jeffersonjhunt/pinled/docs/REQUIREMENTS.md

# Firmware Requirements — `pinled` v2

Requirement IDs are stable; status is `MVP` (first working build), `v1`
(feature-complete for release), or `future`. "SHALL" = required, "SHOULD" =
desired, "MAY" = optional.

## 1. Sensing / scan

| ID | Req | Status |
|---|---|---|
| FR-SCAN-1 | The system SHALL scan lamp channels via daisy-chained 74x165 parallel-in / serial-out shift registers, two per module, reading channel state as one serial stream. | MVP |
| FR-SCAN-2 | The system SHALL support 16 channels per module (2× '165, the second feeding the first's `SER`). | MVP |
| FR-SCAN-3 | The system SHALL support 1..8 identical, unaddressed modules chained on a 5-conductor harness. `CLK` and `/PL` are bussed to every module; `DATA` is point-to-point, `QH` → `SER`, one push-pull driver per hop. See `CHAINING.md`. | MVP |
| FR-SCAN-4 | A scan frame SHALL raise `/PL` — capturing every channel in the chain on that one edge — then issue **16*N** clocks, sampling `DATA` in the middle of each bit cell. Stream bit *i* (MSB-first) SHALL be channel *i*; no samples are discarded. Any module count 1..8 SHALL be legal. | MVP |
| FR-SCAN-5 | Per-channel raw sample rate SHALL be configurable and default to 10 kHz. | MVP |
| FR-SCAN-6 | Channel active polarity SHALL be configurable, defaulting to **active-high** (FET + inverting Schmitt trigger = non-inverting front end). | MVP |
| FR-SCAN-7 | The clock burst SHOULD be generated by SPI + DMA (`SCLK`=`CLK`, `MISO`=`DATA`, mode 2, receive-only). `/PL` SHOULD be driven from `CS` with positive polarity, so the line is low between transactions (loading) and high during one (shifting) and the capture instant is hardware-timed. | MVP |
| FR-SCAN-8 | Sampling SHALL be paced to a fixed configured rate independent of channel count. The SPI transaction cadence provides this directly; no separate pacing timer is required. | MVP |
| FR-SCAN-9 | The driver SHALL measure actual frame time at boot, clamp the configured rate to what the hardware sustains at ≤ 60% core occupancy, and publish the resulting rate as the authoritative Fs for all downstream time-constant math. | MVP |
| FR-SCAN-10 | A frame SHALL be a **single** SPI transaction. The driver's fixed per-transaction overhead (~17 µs measured, `TIMING.md` §2.4) is paid once per frame, never once per module. | MVP |
| FR-SCAN-11 | A wrong `num_modules` SHALL degrade benignly in both directions: too high reads hard zeros from the chain terminator, too low leaves trailing modules unread. Neither SHALL shift or misalign the channels that are present. | MVP |

## 2. Filament (brightness reconstruction)

| ID | Req | Status |
|---|---|---|
| FR-FIL-1 | Each channel SHALL run a leaky integrator emulating an incandescent filament's thermal response. | MVP |
| FR-FIL-2 | Attack (rise) and decay (fall) time constants SHALL be independently configurable, default ~20–50 ms. | MVP |
| FR-FIL-3 | The integrator SHALL accept normalized duty (0..1) or per-sample boolean and output brightness 0..255. | MVP |
| FR-FIL-4 | A configurable output gamma/curve SHALL map integrator level → LED PWM to match perceived bulb response. | v1 |
| FR-FIL-5 | Math SHALL be fixed-point (no float in the hot loop) and run for ≥ 64 channels within frame budget. | MVP |

## 3. Auto-profiling

| ID | Req | Status |
|---|---|---|
| FR-PROF-1 | The system SHALL classify each channel as STEADY / MATRIX / AC_STEADY / AC_DIMMED / OFF from observed transitions. | v1 |
| FR-PROF-2 | Profiling SHALL run at boot and be re-armable at runtime. | v1 |
| FR-PROF-3 | Classifier output `{class, duty_norm, period_est, confidence}` SHALL seed each channel's integrator gain/attack/decay. | v1 |
| FR-PROF-4 | A machine profile MAY override or lock per-channel class/params. | v1 |
| FR-PROF-5 | The observation window SHALL be specified in milliseconds (default 500 ms–1 s) and the frame count derived from the measured Fs, so the window spans several AC and matrix periods at any channel count. | v1 |
| FR-PROF-6 | The classifier SHOULD be robust to correlated false edges from solenoid-induced ground bounce (e.g. discard frames in which an implausible fraction of channels transition together). | v1 |

## 4. LED output / mapping

| ID | Req | Status |
|---|---|---|
| FR-LED-1 | The system SHALL drive a WS2812B/SK6812 string from a single GPIO (RMT). | MVP |
| FR-LED-2 | A mapping table SHALL relate sensed channel → LED index(es) + base color. | MVP |
| FR-LED-3 | LED frame/refresh rate SHALL be configurable (default 60–120 Hz) and decoupled from scan rate. | MVP |
| FR-LED-4 | Per-lamp color/tint (e.g. warm-white for GI, colored inserts) SHALL be configurable. | v1 |
| FR-LED-5 | The renderer SHOULD gamma-correct and dither low levels to avoid visible stepping. | v1 |
| FR-LED-6 | The renderer SHALL build one frame and issue a single strip transmit per refresh, not one transmit per channel. | MVP |
| FR-LED-7 | A global brightness/current cap SHALL bound worst-case LED draw (~6 A at 128 LEDs full-on). | v1 |
| FR-LED-8 | `led_count` × per-LED transmit time SHALL be validated against `refresh_hz` at boot and the refresh rate clamped if it does not fit. | MVP |

## 5. Configuration / profiles

| ID | Req | Status |
|---|---|---|
| FR-CFG-1 | Machine profiles (per-lamp name, color, integrator params, profiler locks) SHALL persist across reboots. | v1 |
| FR-CFG-2 | Build-time defaults SHALL be settable via Kconfig (`idf.py menuconfig`). | MVP |
| FR-CFG-3 | Profiles SHALL be loadable/exportable as human-readable JSON — specifically proto3's canonical JSON mapping of the schema in FR-CFG-13, so the readable form is generated rather than separately maintained. | v1 |
| FR-CFG-4 | The system SHALL boot to sane defaults with no stored profile. | MVP |
| FR-CFG-5 | Configuration SHALL be split into two documents: a **machine profile**, keyed by the lamp's number in the machine's own lamp matrix and containing nothing install-specific, and an **install config** holding geometry, pins and wiring. Both SHALL be exportable and importable; only the machine profile SHALL be publishable to the shared registry. | v1 |
| FR-CFG-6 | The install config SHALL carry the channel → lamp-number → LED-index binding that joins the two documents. Importing a machine profile SHALL NOT modify geometry, pins or wiring. | v1 |
| FR-CFG-7 | Both documents SHALL be stored as protobuf files in a filesystem partition, not as NVS blobs (a 128-channel profile is ~16 KB as JSON; the NVS partition is 24 KB total). NVS SHALL retain only what it is good at — the small key-value settings needed at boot: Wi-Fi credentials and author handle. | v1 |
| FR-CFG-8 | Per-channel state SHALL include name, LED index, base color, profiler class lock, and attack/decay overrides — one record written by both the profiler and the UI, with the class lock deciding precedence. | v1 |
| FR-CFG-9 | A **version** SHALL be the install config and machine profile captured together with a label, timestamp and parent lineage, so a user can back up, keep alternative setups, compare them and revert. Versions SHALL be managed by the UI and stored in the user's private cloud area or as local files. | v1 |
| FR-CFG-10 | The device SHALL store exactly **one active configuration** and no version history — only one can be in effect, so on-device copies would be dead weight and a second thing to keep consistent. Switching versions is an ordinary config write; it need not be instantaneous, but the device SHALL report whether applying one required re-initialisation. | v1 |
| FR-CFG-11 | The UI SHALL retain the outgoing configuration when applying a new one, so fallback is a single action. No device-side rollback slot is required: no install-config value can lock the user out (pins, geometry and rates affect only scan and render, never the HTTP server), and Wi-Fi credentials are covered by FR-UI-7. | v1 |
| FR-CFG-12 | Wi-Fi credentials SHALL live in NVS only and SHALL NOT appear in any exported document, at any privacy level. Restoring a backup therefore requires re-provisioning. | v1 |
| FR-CFG-13 | A single `.proto` SHALL be the schema authority. Device ⇄ browser traffic and on-device storage SHALL be **protobuf** (nanopb); the firmware SHALL contain no JSON parser. The browser converts to and from JSON for files, sharing and diffing. Field numbering and unknown-field preservation are what make the FR-UI-4 version window work. | v1 |
| FR-CFG-14 | The document model (nested, named, optional) and the runtime model (flat POD array sized at init) SHALL be distinct types, with load projecting one onto the other — `NFR-4` forbids allocation in the per-frame path that reads the per-channel record. | v1 |
| FR-CFG-15 | Every stored document SHALL carry a CRC over its payload. Filesystem consistency is not write durability; they are different promises. | v1 |
| FR-CFG-16 | Applying a configuration SHALL be write-file-then-restart. In-place re-initialisation of the scan device, integrators and renderer is not required: this is a commissioning-time operation. | v1 |

## 5a. Configuration UI

Architecture, schema and rationale in `WEBUI.md`. The governing constraint is
that the cloud is a convenience and is never required: every function of the
product SHALL be reachable with no internet connection.

| ID | Req | Status |
|---|---|---|
| FR-UI-1 | The device SHALL serve an SPA shell over HTTP on the local network. The application bundle, images, help and registry content MAY be loaded from cloud storage over HTTPS. | v1 |
| FR-UI-2 | The device SHALL NOT make outbound requests to any web service. The browser is the only participant that communicates with both the device and the cloud. | v1 |
| FR-UI-3 | The device API SHALL be unauthenticated and SHALL send `Access-Control-Allow-Origin: *`, so that a standalone copy of the SPA run from `file://` (origin `null`) can reach it. | v1 |
| FR-UI-4 | `GET /api/v1/info` SHALL report an **API version** distinct from the firmware version, so a cloud-updated bundle can support field devices running older firmware. | v1 |
| FR-UI-5 | The device SHALL push live per-channel state and profiler classification over a WebSocket at ~30 Hz, carrying a **sticky "active since last push"** bit per channel (cleared on send) so activity between pushes is not lost. This reuses the FR-DIAG-1 mechanism. The frame is a protobuf envelope wrapping a packed `bytes` payload. | v1 |
| FR-UI-9 | The push task SHALL run at low priority off the scan core, and SHALL **drop pushes rather than stall `scan_task`** under load. The sticky bit makes a dropped push lossless. No message broker SHALL be introduced: a cloud broker violates FR-UI-2, and an on-device broker still needs the WebSocket underneath it. | v1 |
| FR-UI-6 | Unprovisioned, the device SHALL raise a SoftAP with a captive portal whose provisioning page is **self-contained on the device**, with no cloud dependency. After joining, it SHALL report both its mDNS name and its numeric IP. | v1 |
| FR-UI-7 | A button-held rescue path SHALL return a provisioned device to SoftAP mode. | v1 |
| FR-UI-8 | The SPA SHALL be downloadable as a standalone bundle that runs locally against the device API with no cloud access. | v1 |

## 5b. Firmware update

| ID | Req | Status |
|---|---|---|
| FR-OTA-1 | The device SHALL accept a firmware image by HTTP POST from the browser and apply it via the OTA API. It SHALL NOT fetch images itself. | v1 |
| FR-OTA-2 | An uploaded image SHALL be **staged into the inactive slot and not booted** until a **physical button press** confirms it, within ~30 s, with the pending state and its remaining time readable from the API. On expiry the staged image SHALL be discarded. Physical presence is the entire authorisation; open CORS otherwise leaves a bricking endpoint permanently exposed. *Confirming after the upload rather than arming before it is deliberate: writing an inactive slot is harmless, so the act worth gating is the boot-partition switch. The press then confirms a specific image the device has already verified, instead of opening a window in which anything on the LAN may be uploaded — and a truncated image can never reach the confirmation.* | v1 |
| FR-OTA-3 | Image integrity SHALL be checked against a published SHA-256 before upload, and ESP-IDF's app-descriptor validation SHALL remain enabled. Signed images / secure boot are `future`. | v1 |
| FR-OTA-4 | USB flashing SHALL remain a fully supported first-class update path, not a recovery hatch. | MVP |
| FR-OTA-5 | The partition table SHALL provide two OTA app slots plus a filesystem partition (`WEBUI.md` §7). | v1 |
| FR-OTA-6 | Rollback SHALL be enabled: a newly booted image SHALL mark itself valid only once it is serving the API, so a firmware that cannot reach that state is reverted by the bootloader without physical access. | v1 |
| FR-OTA-7 | While an image is staged, a short press SHALL confirm it **instead of** re-arming the profiler (FR-PROF-2), and the indicator SHALL show that the button's meaning has changed (FR-IND-3). The long-hold rescue (FR-UI-7) SHALL remain available in every mode without exception. | v1 |
| FR-REG-1 | Device identity SHALL derive from the factory eFuse MAC — no provisioning step and no stored secret. An optional author handle in NVS SHALL be stamped into exported profiles for attribution. Profile ownership itself is a cloud-side association and no device function SHALL depend on it. | v1 |
| FR-REG-2 | A registered account SHALL have a **private** area holding the user's version library, distinct from the public registry, and it is the only version store in the system (FR-CFG-10). The registry SHALL accept only machine profiles; install configs and versions are private. As with everything else, the browser mediates and the device is not involved (FR-UI-2). | v1 |

## 5c. Status indicator

One RGB pixel, and it exists for two jobs: telling somebody across a dark room
whether the machine is fine, and making the button's *current* meaning visible.
The second matters most — GPIO 0 changes meaning while an image is staged
(FR-OTA-7), and a modal control whose mode is invisible is a trap rather than a
feature.

| ID | Req | Status |
|---|---|---|
| FR-IND-1 | The board SHALL carry a status pixel on its own GPIO, distinct from the playfield string. It SHALL NOT consume a playfield LED: the string is the product, and a machine is commissioned by looking at it. | v1 |
| FR-IND-2 | State SHALL be encoded by **rhythm as well as colour**, such that every state is distinguishable by pattern alone. Red/green is not a distinction for roughly 8% of men, and this indicator is the sole feedback on a device with no screen. | v1 |
| FR-IND-3 | Solid SHALL mean a steady state and blinking SHALL mean the device wants something. A healthy machine is therefore still, and anything moving is a request. While an image is staged the indicator SHALL blink **faster as the confirmation window expires**, conveying the deadline without a display. | v1 |
| FR-IND-4 | Faults SHALL be signalled as *N* red blinks followed by a pause, *N* identifying the class per the table below, so a fault is diagnosable by eye and over a telephone without a serial cable. Counting SHALL start at **2**, because one blink and a pause reads as a heartbeat rather than a count. Where several faults are active the **lowest** number SHALL be shown; the API reports all of them. Red SHALL NOT imply the device is dark — it keeps running wherever it can, so red means *not doing what you asked*. | v1 |
| FR-IND-7 | Every press past the debounce threshold SHALL be acknowledged **immediately and identically**, before and independently of whatever it goes on to do, so that "did it register" is never a question. A press too short to count SHALL produce no acknowledgement, making the absence itself the answer. | v1 |
| FR-IND-8 | While the button is held past one second the indicator SHALL show progress toward the erase threshold, accelerating as it approaches, and SHALL return to the previous state if released early. The rescue countdown is otherwise visible only in a log nobody standing at a machine can read. | v1 |
| FR-IND-5 | Brightness SHALL be configurable in the install config, including **off**. The board may be visible in a backbox, and the indicator must never compete with the playfield. | v1 |
| FR-IND-6 | The indicator SHALL NOT be on the scan or render hot path: it is driven from a low-priority task and a dropped update is of no consequence. | v1 |

States, in the order they are reached:

| State | Colour | Rhythm |
|---|---|---|
| Booting | white | solid |
| Running, network up | green | solid, dim |
| Running, no network | green | slow breathe (~0.5 Hz) — works, not reachable |
| SoftAP / unprovisioned | blue | fast blink |
| Profiler pass running | white | one brief flash |
| **Image staged, press to confirm** | amber | blink, accelerating as the window expires |
| Writing / applying firmware | amber | solid — do not remove power |
| Fault | red | *N* blinks, pause, repeat |

Blue for SoftAP rather than green: it is a *mode awaiting action*, not a
degraded run, and it keeps the two states a person must tell apart off the
red/green axis entirely.

### Fault classes (FR-IND-4)

Grouped by **the subsystem someone can act on**, not by where the error was
raised, and ordered by expected frequency — a count is only useful if it is
easy to read, and the common ones get read most.

| Blinks | Class | Check |
|---|---|---|
| 2 | Sense bus | scan init failed, or no usable sample rate. The harness: `CLK INH` floating and a missing `QH`→`SER` are the top rev D faults |
| 3 | Configuration | a stored document was rejected — CRC, decode, or a value out of range. Running on defaults; re-apply from the UI |
| 4 | LED string | strip init failed or the geometry is impossible. Data line and LED count |
| 5 | Storage | the filesystem would not mount or would not write. Run the store self-test |
| 6 | Internal | out of memory, a task or the HTTP server would not start. A firmware bug, not a wiring fault |

Rate: 200 ms on, 200 ms off per blink, then a 1.2 s pause — so two blinks is a
2 s cycle, countable without being frantic.

### Press feedback (FR-IND-7, FR-IND-8)

| Moment | Indicator |
|---|---|
| press accepted (past debounce) | one **80 ms white blip**, whatever it will go on to do |
| press too short to count | **nothing** — the absence is the answer, and the log gives the duration |
| held ≥ 1 s | **red**, blinking faster each second toward the 5 s erase |
| released before 5 s | back to the previous state |
| after release | the action's own state — white flash for a profiler pass, solid amber for applying firmware |

Acknowledging the *press* rather than its *consequence* is the point. A profiler
pass cannot be the acknowledgement, because during a staged image the button
means something else and amber is already blinking — and because a press whose
only feedback is its outcome is indistinguishable from a press that never
registered. That exact ambiguity cost a bench session on 2026-08-14.

Red for the erase countdown overlaps the fault colour deliberately: it is a
destructive action one second away and red is what that deserves. It is
distinguishable because it happens only while the button is held, and because
it accelerates.

Fault classes for FR-IND-4 are assigned where the fault is raised; the mapping
belongs in `BRINGUP.md` beside the other things read off a board by eye.

## 6. Diagnostics

Bring-up aids. All default to off/normal so production behavior is unchanged;
see `BRINGUP.md` for how they are used together.

| ID | Req | Status |
|---|---|---|
| FR-DIAG-1 | The firmware SHALL be able to log the raw pre-filament channel bitmap plus a sticky per-channel "has been seen both high and low" flag (`PINLED_SCAN_DEBUG`), isolating the sense bus from the filament model and the LED string. | MVP |
| FR-DIAG-2 | The firmware SHALL be able to advance the scan at a human-visible rate (`PINLED_SCAN_STEP_MS`), logging each bit index, the channel it maps to, and the level read. The chain holds no analog state, so it can be clocked arbitrarily slowly. It SHALL re-assert `/PL` between steps rather than walking one frozen snapshot, so an input toggled part-way through the walk is still visible. | MVP |
| FR-DIAG-3 | The firmware SHALL be able to park the chain on a single channel indefinitely (`PINLED_SCAN_HOLD_CH`): snapshot, clock exactly *k* times, stop. `DATA` then holds channel *k* as a static DC level a meter can read. Holding `/PL` **low** instead is the useful special case — the registers stay transparent, so `DATA` tracks module 1 channel 0 *live*, following a button in real time. | MVP |
| FR-DIAG-4 | Modes that take ownership of the chain SHALL suppress `scan_task` rather than race it, and SHALL say so in the log. | MVP |

## 7. Non-functional

| ID | Req | Status |
|---|---|---|
| NFR-1 | Target ESP-IDF **5.5.x**, IDF_TARGET `esp32s3`. Reference board is the Adafruit QT Py ESP32-S3; the ESP32-S3-DevKitC-1 is a supported bring-up board (same GPIO numbers, see `HARDWARE.md`). Neither is the shipping form factor — the product places a bare S3 on the mainboard. | MVP |
| NFR-2 | Reusable logic (scan, filament, profiler) SHALL be ESP-IDF components with public headers under `include/`. | MVP |
| NFR-3 | Code style SHALL follow the existing repos: C++, `ooe::pinled` namespace, Doxygen headers, `esp_err_t` returns, `ESP_LOG*` with per-file `TAG`, `ESP_ERROR_CHECK`. | MVP |
| NFR-4 | No dynamic allocation in per-sample / per-frame hot paths. | v1 |
| NFR-5 | BOM target ≤ ~$25/strip; original ESP32-class MCU. | v1 |
| NFR-6 | License MIT; third-party attributions retained under `licenses/`. | MVP |
| NFR-7 | The CPU SHALL run at 240 MHz (`CONFIG_ESP_DEFAULT_CPU_FREQ_MHZ_240`). Every figure in `TIMING.md` §2 derives from it and the IDF default for `esp32s3` is 160 MHz, which inflates the frame budget by 1.5×. | MVP |
| NFR-8 | The shipping board SHALL carry **8 MB** flash (no PSRAM required). Two 3 MB OTA slots plus a filesystem partition do not fit in 4 MB with any margin (`WEBUI.md` §7). *(Settled 2026-08-08; the mainboard places a bare S3, so flash size is a BOM choice — cheap now, expensive after layout.)* | v1 |

## 8. Hardware contract

Properties of the board the firmware depends on. Changing one of these is a
firmware change, not just a hardware change — see `TIMING.md` for derivations.

| ID | Req | Status |
|---|---|---|
| HW-1 | The front end SHALL be non-inverting overall (level-shift MOSFET followed by an *inverting* Schmitt trigger, e.g. 74LVC14): lamp on → logic high. This sets the `active_low` default. | MVP |
| HW-2 | Every `DATA` net SHALL carry a ~10 kΩ pull-down **at its receiving end** — one per module on `J2.3`, plus one at the master on `MISO` — oriented so that an absent, unpopulated or unpowered upstream driver reads *lamp off*, which given HW-1 means pulled low. The MCU's internal pull on `MISO` SHALL be configured to match rather than left at the `gpio_reset_pin()` default (pull-up). HW-1, HW-2 and the internal pull are one decision. | MVP |
| HW-3 | Chain logic SHOULD be LVC family at 3.3 V, for edge rate and drive into the multi-drop `CLK` bus. `74LV165A` is an acceptable substitute; `74HC165` is acceptable at **≤ 4 MHz** and is the practical choice for a through-hole bench build. *(Relaxed from ≤ 2 MHz on 2026-08-07: 4 MHz ran clean on a 4-chip breadboard rig, 2 modules / 32 ch at 3.3 V, for millions of frames with zero read errors. The limit at longer chains is multi-drop `CLK` integrity across 800 mm, not the part — see HW-14 and `TIMING.md` §4.3 — so this ceiling is about the device, and chain length is governed separately.)* Since rev D there is no per-hop gate delay in the clock path, so family choice is no longer a chain-length correctness issue. | MVP |
| HW-4 | Modules SHALL chain on a **5-pin** JST-SH harness: `VCC` (5 V), `GND`, `DATA`, `CLK`, `/PL`, in ~100 mm hops, up to 8 modules / 800 mm. `CLK` and `/PL` are bussed; `DATA` is point-to-point and is the only signal that differs between `J1` and `J2`. | MVP |
| HW-5 | Each module SHALL carry local decoupling (100 nF per IC + ~10 µF bulk). `CLK` SHALL have 33–100 Ω series termination **at the master** (the bus source), and each module's `QH` SHALL have a 33 Ω series resistor before `J1` — source-terminating the point-to-point hop and current-limiting an output collision if a module is reversed. | MVP |
| HW-6 | pinled ground SHALL tie to the machine's lamp-return ground at a single point near the lamp matrix return. | MVP |
| HW-7 | The input SHALL survive rail sag from solenoid firing (series Schottky + bulk capacitance + kickback clamping) without an MCU brownout reset. | MVP |
| HW-8 | Distribution SHALL be 5 V on the harness with a local 3.3 V LDO on every module. LVC is not a 5 V part, so this is now required rather than preferred. Higher input rails require a single switching regulator at the controller, not per-module switchers adjacent to the sense bus. | MVP |
| HW-9 | The LED data line SHOULD be level-shifted to meet WS2812B V_IH (0.7 × VDD), or the strip run at a reduced VDD. | v1 |
| HW-10 | No analog time constant may appear anywhere in the chain. Every capture and every transfer SHALL be registered and edge- or level-defined. | MVP |
| HW-11 | The chain SHALL be **self-terminating**: a partially populated harness reads as lamps-off beyond the last fitted module, with no terminator plug, jumper or build variant (HW-2's per-module pull-down provides this). | MVP |
| HW-12 | Each module's serial output SHALL be taken from `QH`, never `/QH`. Inverting the serial output would make an absent module's pull-down read as every channel *on*, defeating HW-11. | MVP |
| HW-13 | `J1` (upstream, `DATA` = output) and `J2` (downstream, `DATA` = input) SHALL be keyed or gendered so a module cannot be fitted backwards, which would tie two push-pull outputs together. | MVP |
| HW-14 | The `CLK` bus SHALL be routed so it propagates *along* the harness, master to downstream, rather than star-wired. This keeps each module clocked before the one feeding it, so harness skew adds to the inter-device hold margin instead of eroding it (`CHAINING.md`). | MVP |
| HW-15 | The mainboard SHALL carry a **status pixel** (one WS2812-class RGB LED) on its own GPIO, with its own decoupling, sited so it is visible with the board installed. It SHALL NOT be the first pixel of the playfield string: the string is the product and is routed to the playfield, whereas this has to be readable at the board (FR-IND-1). On the QT Py bench board the onboard pixel serves, on GPIO 39 with power-enable on 38. | v1 |
| HW-16 | GPIO 0 (the BOOT button, or its equivalent on the mainboard) SHALL be the sole physical control, carrying three meanings distinguished by duration and context: short press re-profiles (FR-PROF-2), short press **while an image is staged** confirms it (FR-OTA-7), long hold erases the network (FR-UI-7). No second button is required, and the indicator is what makes the modal meaning legible (FR-IND-3). | v1 |

## 9. Out of scope (first cut)
- Any device-initiated call to a cloud service (FR-UI-2) — including
  device-pull OTA, telemetry, and cert issuance. The browser mediates.
- TLS on the device, and the per-device certificate infrastructure a
  cloud-hosted SPA would require (`WEBUI.md` §1).
- Device-side authentication or user accounts. Ownership and verification live
  in the sharing service (FR-REG-1).
- The cloud sharing service itself, and native mobile apps.
- Reverse-engineering per-title lamp tables (baseline behavior comes from
  sensing, not decoding ROM state).
- PCB/gerber design (tracked in the hardware repo, not firmware).

*Web config portal, Wi-Fi provisioning and OTA were out of scope through
2026-08-08 and are now specified in §5a/§5b.*
