jeffersonjhunt/pinled/docs/pinled_module_revC.kicad_sch

## KiCad design docs/pinled_module_revC.kicad_sch (2026-08-04)

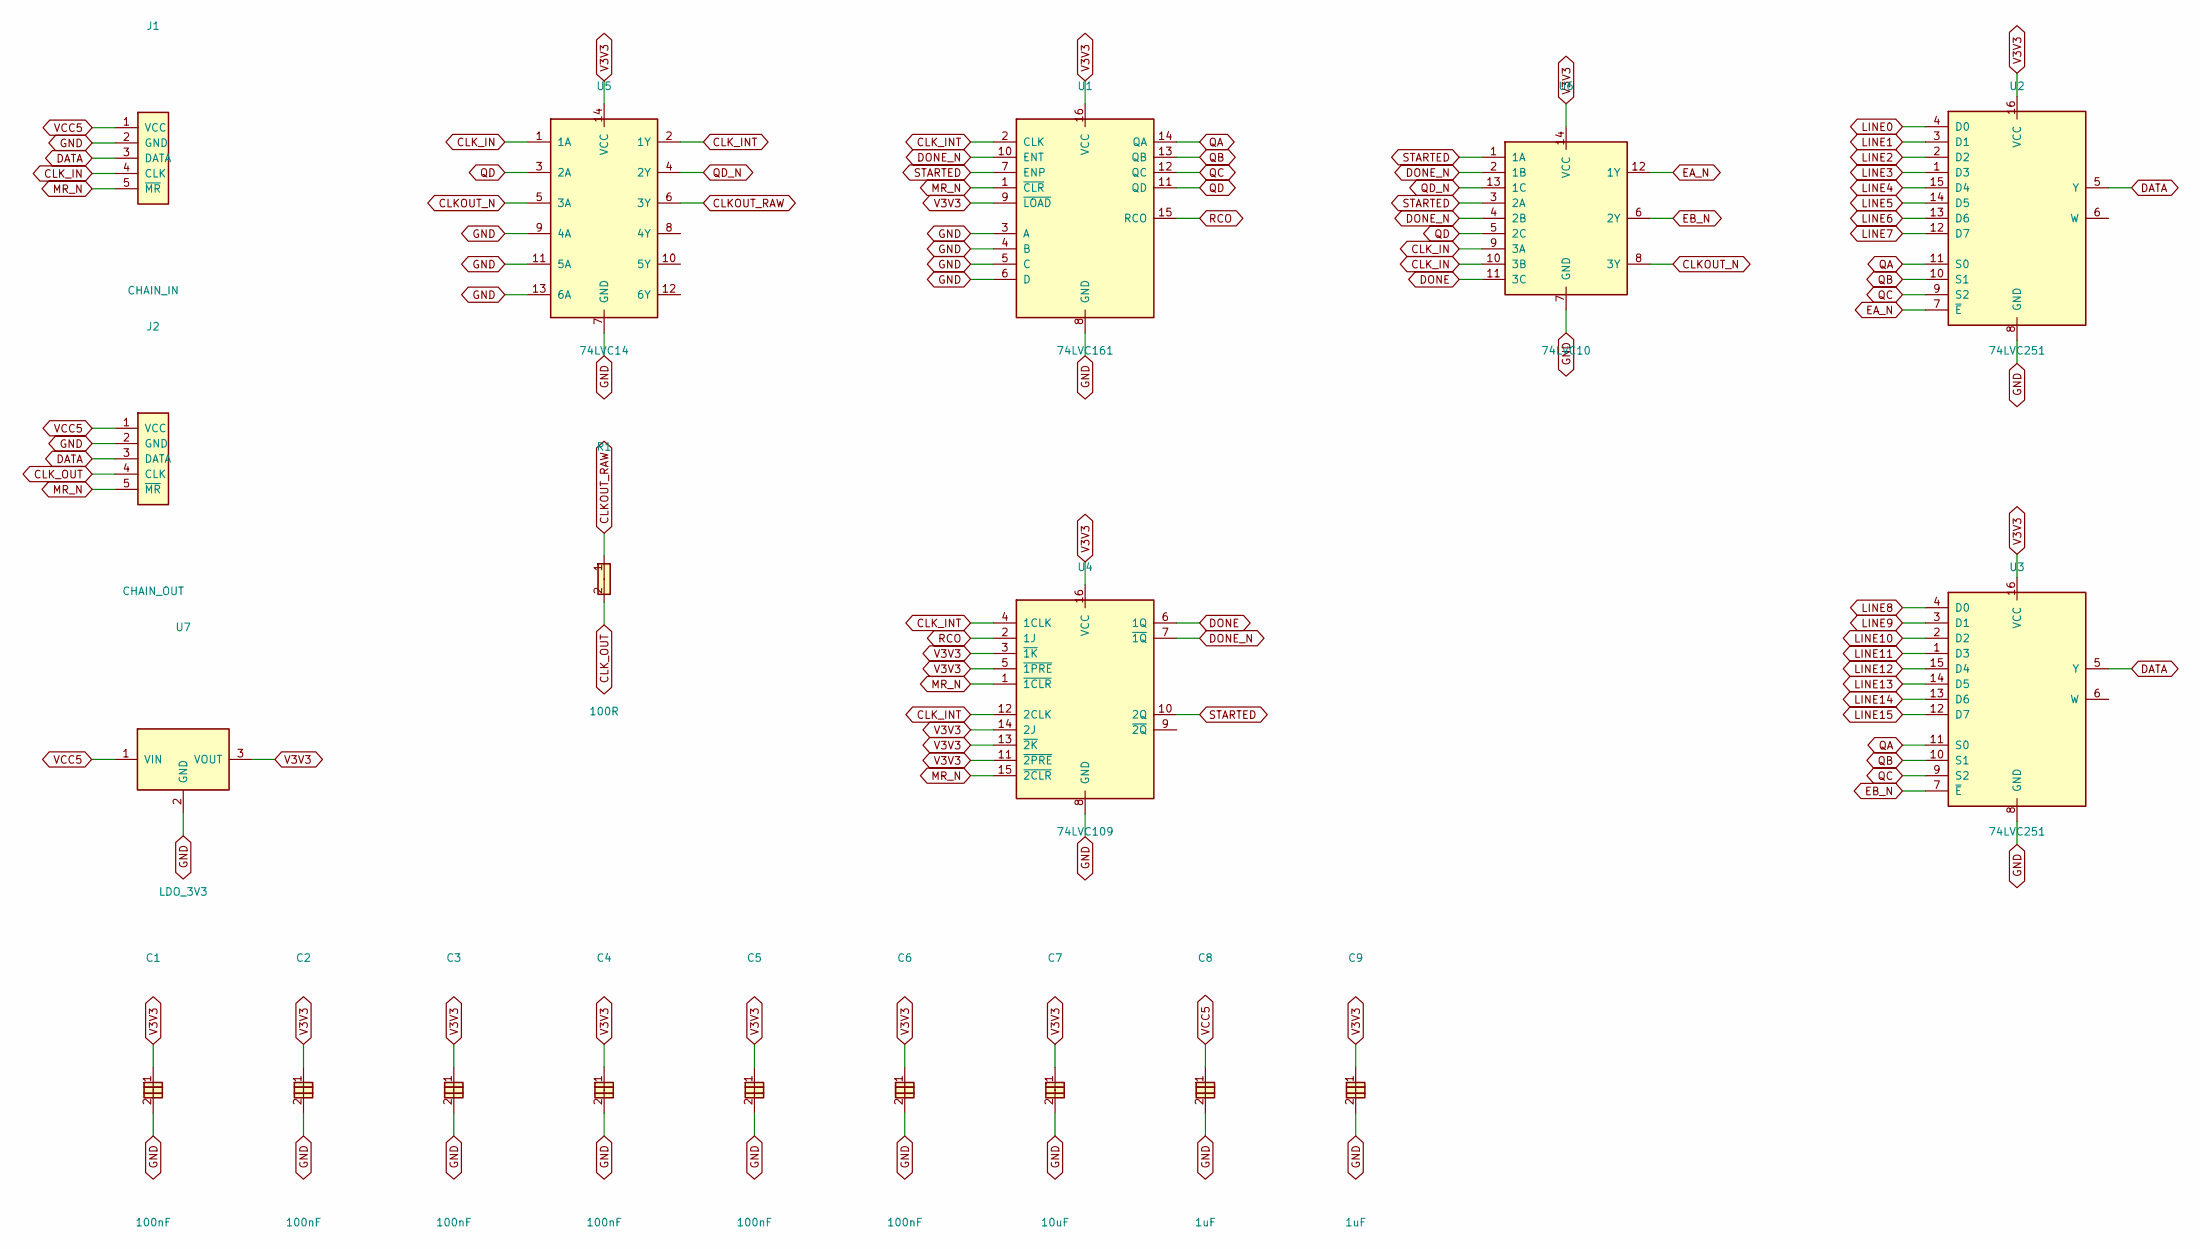
[picture p1: schematic pinled_module_revC.kicad_sch]

Parts:
C1, C2, C3, C4, C5, C6: 100nF
C7: 10uF
C8, C9: 1uF
J1: CHAIN_IN
J2: CHAIN_OUT
R1: 100R
U1: 74LVC161
U2, U3: 74LVC251
U4: 74LVC109
U5: 74LVC14
U6: 74LVC10
U7: LDO_3V3

Connections:
CLKOUT_N: U5.5 (3A), U6.8 (3Y)
CLKOUT_RAW: R1.1, U5.6 (3Y)
CLK_IN: J1.4 (CLK), U5.1 (1A), U6.9 (3A), U6.10 (3B)
CLK_INT: U1.2 (CLK), U4.4 (1CLK), U4.12 (2CLK), U5.2 (1Y)
CLK_OUT: J2.4 (CLK), R1.2
DATA: J1.3 (DATA), J2.3 (DATA), U2.5 (Y), U3.5 (Y)
DONE: U4.6 (1Q), U6.11 (3C)
DONE_N: U1.10 (ENT), U4.7 (~1Q), U6.2 (1B), U6.4 (2B)
EA_N: U2.7 (~E), U6.12 (1Y)
EB_N: U3.7 (~E), U6.6 (2Y)
GND: C1.2, C2.2, C3.2, C4.2, C5.2, C6.2, C7.2, C8.2, C9.2, J1.2 (GND), J2.2 (GND), U1.3 (A), U1.4 (B), U1.5 (C), U1.6 (D), U1.8 (GND), U2.8 (GND), U3.8 (GND), U4.8 (GND), U5.7 (GND), U5.9 (4A), U5.11 (5A), U5.13 (6A), U6.7 (GND), U7.2 (GND)
LINE0: U2.4 (D0)
LINE1: U2.3 (D1)
LINE2: U2.2 (D2)
LINE3: U2.1 (D3)
LINE4: U2.15 (D4)
LINE5: U2.14 (D5)
LINE6: U2.13 (D6)
LINE7: U2.12 (D7)
LINE8: U3.4 (D0)
LINE9: U3.3 (D1)
LINE10: U3.2 (D2)
LINE11: U3.1 (D3)
LINE12: U3.15 (D4)
LINE13: U3.14 (D5)
LINE14: U3.13 (D6)
LINE15: U3.12 (D7)
MR_N: J1.5 (~MR), J2.5 (~MR), U1.1 (~CLR), U4.1 (~1CLR), U4.15 (~2CLR)
QA: U1.14 (QA), U2.11 (S0), U3.11 (S0)
QB: U1.13 (QB), U2.10 (S1), U3.10 (S1)
QC: U1.12 (QC), U2.9 (S2), U3.9 (S2)
QD: U1.11 (QD), U5.3 (2A), U6.5 (2C)
QD_N: U5.4 (2Y), U6.13 (1C)
RCO: U1.15 (RCO), U4.2 (1J)
STARTED: U1.7 (ENP), U4.10 (2Q), U6.1 (1A), U6.3 (2A)
V3V3: C1.1, C2.1, C3.1, C4.1, C5.1, C6.1, C7.1, C9.1, U1.9 (~LOAD), U1.16 (VCC), U2.16 (VCC), U3.16 (VCC), U4.3 (~1K), U4.5 (~1PRE), U4.11 (~2PRE), U4.13 (~2K), U4.14 (2J), U4.16 (VCC), U5.14 (VCC), U6.14 (VCC), U7.3 (VOUT)
VCC5: C8.1, J1.1 (VCC), J2.1 (VCC), U7.1 (VIN)
