jeffersonjhunt/pinled/(commit log)

2026-07-17 migrate to version 0.2.0
    [partitions.csv]
2026-07-17 fix stack overflow in auto-profiling: move channel arrays to heap
    [main.cpp]
2026-07-28 plan chained-module architecture: timing budgets, S3 retarget, polarity flip
    Design pass for the chained-module scan bus (8-128 channels) on the
    QT Py ESP32-S3. Docs only, plus three default-value flips.
    New docs/TIMING.md covers:
    - sense-side frame budget across 1-8 modules (3.2 us at 16 ch,
    23.5 us at 128), and why the scan rate must be paced at a fixed
    10 kHz rather than free-run: frame time is linear in channel
    count, so a Kconfig sample-rate constant makes the filament time
    constants wrong by 3-25x depending on configuration
    - dedic_gpio (~8 ns/op, S3 only) as the baseline, not a future
    optimization; the bundle must be created on the scan task's core
    - LED bud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
    [lamp_scan.h, machine_config.h]
2026-07-28 M0.5: retarget to esp32s3 (QT Py ESP32-S3, 8MB no PSRAM)
    Build target, flash size, console routing, and the four GPIO defaults.
    No functional changes to the scan/filament/render path - that is M1a.
    - CONFIG_IDF_TARGET esp32 -> esp32s3, 8 MB flash (FN8C0 variant)
    - CONFIG_ESP_CONSOLE_USB_SERIAL_JTAG: the QT Py ESP32-S3 has no
    USB-UART bridge, USB-C goes straight to the S3's native USB.
    Without this the console sits on UART0 and monitor shows nothing.
    - both CMake presets retargeted
    - pins remapped to 18/17/9/8 (A0-A3). The POC defaults were not just
    wrong but unusable: GPIO 26 and 27 are SPI flash pins on the S3,
    and 15 and 25 are not broken out on this board.
    - PIN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
    [machine_config.cpp]
2026-08-02 set CPU frequency to 240 MHz
    The esp32s3 IDF default is 160 MHz. Every scan-budget number in
    docs/TIMING.md section 2 is derived from a 240 MHz LX7, so the default
    inflated the frame budget by 1.5x (~8 ns -> ~12.5 ns per dedic_gpio op,
    23.5 us -> ~35 us for a 128-channel frame).
    Caught on first hardware bring-up of the ESP32-S3 DevKit; "cpu freq:
    160000000 Hz" in the boot log. Verified 240 MHz after reflash.
2026-08-02 add scan bring-up diagnostic; fix DATA_IN internal pull
    Two problems found during first hardware bring-up with test inputs.
    lamp_scan: gpio_reset_pin() enables the internal pull-UP and
    gpio_set_direction() does not clear it, so DATA_IN sat with a ~45k
    pull-up. That fights the module's 1k bias resistor and, with the
    non-inverting front end, makes an undriven bus read "lamp on" -- the
    opposite of HW-2. Now configured explicitly, with the internal bias
    following active_low so polarity and bias stay one decision.
    main: nothing observable existed short of the LED string, so a dead
    scan chain and a dead LED path looked identical. PINLED_SCAN_DEBUG
    (default y) logs the raw pre-filament bitmap at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
    [lamp_scan.cpp, main.cpp, main.h]
2026-08-02 add slow-step scan mode for counter bring-up
    At normal speed the scan runs ~50k frames/s, so the '161 Q outputs
    toggle near 800 kHz and indicator LEDs on them read as steadily lit.
    That makes "is the counter counting?" unanswerable by eye, which is
    exactly the question during first bring-up.
    PINLED_SCAN_STEP_MS (default 0 = off) advances the scan one channel
    every N ms instead, logging the count, the Q pattern to expect, and the
    DATA_IN level at each step. While non-zero, scan_task is not started so
    the walk owns the counter position.
    lamp_scan gains step_counter() / sample_now() to expose single-step
    control without disturbing read_frame().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
2026-08-02 add hold-channel bring-up mode
    The slow-step walk proves whether the counter counts, but it sweeps past
    any given channel for only a few hundred ms per cycle, which is useless
    for tracing a dead signal path with a meter.
    PINLED_SCAN_HOLD_CH (default -1 = off) pulses /MR, clocks to one channel
    and stops. Every node from the '161 Q outputs through the mux address
    lines, the selected data input, Y, and the MCU pin becomes a static DC
    level, so the break can be localized by measuring along the chain.
    Takes precedence over PINLED_SCAN_STEP_MS; both suppress scan_task.
2026-08-03 docs: record M0.5/M1b results, DevKit, 240 MHz, diagnostics
    Docs had not caught up with this session's hardware bring-up.
    - BRINGUP.md (new): the three diagnostics as a ladder, fault signature
    tables, '151 bench substitution caveats, and the tooling traps that
    present as hardware faults -- port-open resets the board via RTS, ROM
    download mode is indistinguishable from a hang, new Kconfig symbols
    need a reconfigure.
    - REQUIREMENTS: NFR-7 pins the CPU at 240 MHz (TIMING section 2 derives
    from it; the IDF esp32s3 default is 160). New section 6 FR-DIAG-1..4
    for the diagnostics. HW-2 now covers the MCU internal pull. NFR-1
    admits the DevKitC-1 and notes neither dev board is the shi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
2026-08-03 docs: adopt the 4-wire clock-forwarding chain design
    Replaces the strapped-module-ID scheme (which was my inference and was
    never built) with the clock-as-token design from schematic rev A, plus
    the decisions taken on review.
    Design decisions carried in:
    - 4-pin JST-SH: VCC, GND, DATA, CLK. No /MR conductor -- the frame
    reset is a clock-idle timeout. Frees GPIO 17.
    - Master clocks the frame as one receive-only SPI + DMA transaction,
    mode 1. This is correctness, not optimization: the chain holds bus
    arbitration on an RC and a mid-frame stall silently resets it.
    Deletes the dedic_gpio bundle and the gptimer pacing.
    - 1 kOhm DATA bias retained, at the master only (rev A proposed 100k).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
    [pinled_module.kicad_sch]
2026-08-03 lamp_scan: clock the chain from SPI + DMA
    Replaces the bit-bang scan loop with one receive-only SPI transaction
    per frame (M1a). SCLK = CLK, MISO = DATA, no CS, no MOSI. Collapses
    data_pins[] to a single data_pin, and makes mr_pin optional: production
    modules have no reset conductor and clear on the clock-idle timeout, so
    CONFIG_PINLED_MR_GPIO now defaults to -1 (not fitted).
    The diagnostics need per-edge control of CLK, which SPI cannot give, so
    compiling in PINLED_SCAN_STEP_MS or PINLED_SCAN_HOLD_CH selects the
    bit-bang backend instead. Both are bench-rig only regardless.
    SPI mode corrected to 0, and the docs with it. The earlier docs claimed
    mode 1 on the reasoning that it "samples just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
    [lamp_scan.cpp, lamp_scan.h, machine_config.cpp, machine_config.h, main.cpp]
2026-08-03 docs: record SPI + mode-0 validation on the bench rig
    Adding a 74HC14 in the CLK path makes the bench rig advance its counter
    on the falling edge, as a real module does. With that, mode 0 reads
    inputs D4-D7 at channels 4-7 with no shift, confirming the sample lands
    mid-window and line 0 is captured.
    That validates the production sampling phase without rev B hardware --
    the one part of the SPI design that previously could not be checked. The
    inverter mod is now recommended in BRINGUP section 5.
2026-08-03 add chain clock sweep diagnostic; record measured ceiling
    PINLED_SPI_SWEEP steps the chain clock 1..40 MHz and reports, per rate,
    how many of 256 reads agreed and the union of every bit seen. Needs one
    held input and no reflash per step; lamp_scan gains set_clock() to
    re-open the SPI device at a new rate.
    Measured on the '161 + '151 rig (HC parts, breadboard, extra 74HC14 in
    the clock path):
    1-16 MHz 256/256 stable, correct channel
    20-26.7 MHz 256/256 stable, OFF BY ONE CHANNEL
    40 MHz unstable
    The break between 62.5 ns and 50 ns puts the endpoint round-trip delay
    at ~55-60 ns, consistent with `delay < T_clk` -- the same inequality
    TIMING section 4.3 applies to chain skew,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
    [lamp_scan.cpp, lamp_scan.h, main.cpp, main.h]
2026-08-04 rev C: 5-wire chain with /MR, drop the RC activity detector
    Adds a fifth conductor and spends the '109's unused second half on a
    STARTED latch, replacing the RC that rev B used for bus arbitration.
    /MR alone could not have done it: after a reset every module has
    DONE=0, so gating /OE on /DONE would put every module on the bus at
    once. A module still needs local evidence that its turn began -- it just
    does not need a capacitor for it.
    What that removed:
    - tau and the >=5tau idle gap. 128 ch now 68 us/frame, ceiling
    ~14.5 kHz against rev B's 10.9 kHz.
    - The ~6 us mid-frame stall cliff. SPI+DMA is now a throughput choice,
    not a correctness requirement.
    - D1/R1/C1, and with them a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
    [pinled_module.kicad_sch, pinled_module_revC.kicad_sch]
2026-08-04 docs: record CS-driven /MR validation and the stale-log trap
    /MR from SPI CS with SPI_DEVICE_POSITIVE_CS verified on the bench rig:
    channels 4-7 read correctly including simultaneous presses, so the
    frame reset is hardware-timed with no software involvement. That was
    the rev C mechanism most likely to need adjusting; it did not.
    Also records a tooling trap I walked into. The serial logger had a fixed
    2 hour lifetime and expired under a second before a round of button
    presses. Its tail showed all-zeros with no toggles -- indistinguishable
    from a dead scan -- and I read it as a regression in a design that was
    working, while the user was watching the LEDs light correctly. The
    logger now runs u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
2026-08-04 lamp_map: one strip transmit per frame (FR-LED-6)
    render() called neopixel_SetPixel(ctx, &px, 1) once per channel. The
    driver silently discards calls spaced closer than one strip time -- its
    own header says "some data will simply not be displayed" -- and those
    calls were issued microseconds apart, so most were thrown away and LEDs
    kept showing stale values. This was a correctness bug, not just a
    wasteful one, which is why FR-LED-6 is a SHALL.
    Now the whole strip is built into a frame buffer allocated once at init
    (never in the render path, NFR-4) and transmitted once. LEDs with no
    channel mapped are driven dark, so the output is a pure function of
    levels[] rather than of what was displayed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
    [lamp_map.cpp, lamp_map.h]
2026-08-04 wire in 10 kHz pacing and the boot feasibility check
    FR-SCAN-5/8: a gptimer at Fs notifies scan_task, one frame per tick.
    Uniform dt is what the filament integrator assumes, so this is a fixed
    tick rather than burst-and-sleep. ulTaskNotifyTake returns the pending
    count, so a value above 1 means alarms fired while we were still busy;
    those are counted and warned about, rate-limited. The old free-running
    loop with its periodic vTaskDelay to feed the WDT is gone -- the task
    now blocks on the notification, which yields naturally.
    FR-SCAN-9: measure_and_clamp_fs() free-runs 256 frames at boot, times
    them, and clamps the configured rate to 60% of the free-run ceiling. The
    clamped value -- not the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
    [lamp_scan.cpp, main.cpp, main.h]
2026-08-04 rev D: replace the counter+mux chain with 74x165 shift registers
    Rev C spent six logic ICs per module building a distributed state
    machine whose only job was taking turns on a shared DATA bus. A shift
    register chain is taking turns, so the state machine disappears: two
    '165s per module, QH -> SER between them, CLK and /PL bussed.
    What changes:
    - 16 clocks per module instead of 17. No arm clock, nothing discarded;
    a '165 presents channel 0 at QH while /PL is still low.
    - All 16*N channels captured on one edge (the /PL rise) instead of
    swept across the frame. Channel 0 and channel 127 were 35 us apart.
    - SPI mode 0 -> mode 2. The '165 shifts on the rising edge, so the
    master samples on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
2026-08-07 rev D: convert lamp_scan from the 17*N counter framing to 16*N shifts
    The docs went to rev D in 2c903eb while the code still implemented rev C.
    This closes that gap.
    Framing: a frame is now exactly 16 clocks per module. There is no arm clock
    and nothing is discarded, so stream bit i is channel i and the unpack loop
    loses its stride arithmetic. Both legal channel counts are whole bytes, so a
    frame also carries no surplus clocks.
    /PL replaces /MR throughout (mr_pin -> pl_pin, PINLED_MR_* -> PINLED_PL_*,
    PINLED_ARM_CLOCK deleted). The CS mechanism is unchanged -- positive-polarity
    CS, low between transactions, high during -- but the GPIO fallback path
    inverts: /MR idled high, /PL idles low so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
    [lamp_scan.cpp, lamp_scan.h, machine_config.cpp, machine_config.h, main.cpp, main.h]
2026-08-07 sdkconfig: target the FH4R2 QT Py (4 MB flash), not the FN8C0
    The bench board that arrived is the 4 MB flash / 2 MB PSRAM variant; the
    defaults were written for the 8 MB no-PSRAM part. Both variants share a
    silkscreen and a USB VID/PID, so the comment now records how to tell them
    apart and why 4 MB is correct for either: partitions.csv needs ~1.06 MB, and
    declaring 8 MB on an FH4R2 configures flash that is not present.
2026-08-08 docs: SPI mode 2 is measured, not reasoned
    The single unmeasured claim the rev D framing rested on was settled on the
    bench 2026-08-06: a 4x 74HC165 rig (2 modules, 32 ch) at 4 MHz read U1.D as
    channel 4 and U2.D as channel 12, exactly. The exact landing is the proof --
    mode 3 samples on the shift edge and would slide the whole frame by one, so
    alignment from bit zero fixes CPHA as well as CPOL. Re-confirmed 2026-08-07 on
    a QT Py ESP32-S3 (FH4R2).
    The same run settled bit order (H first, no byte reversal), the QH->SER handoff
    within and across a module boundary, /PL from CS, and frame timing (26.8 us for
    32 ch -> 37274 Hz free-run, 27% duty at 10 kHz).
    Also downgrades the '165 pinout cavea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
    [lamp_scan.cpp, lamp_scan.h]
2026-08-08 docs: HW-11 self-termination confirmed on the bench
    Chips 3-4 pulled live from the 4x '165 rig 2026-08-07. Channels 16-31 held a
    hard zero across ~4.9 M frames with not one toggle flag set.
    The positive control is what makes it conclusive rather than merely quiet: with
    the module out, U1.D still read channel 4 and U2.D channel 12, so the frame was
    still 32 bits and the trailing 16 were genuinely being clocked from a
    pulled-down SER rather than from a dead chain. Groups 3-4 also stayed clean
    DURING those presses, so the 10k terminator holds against crosstalk on the
    shared CLK//PL bus, not just against quiescence.
    Every rev D correctness claim is now measured. What remains is diagnostic
    poli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
2026-08-08 docs: describe the bench rig as actually wired
    The rig has four buttons, not 32: the D input (pin 14) on each of the four
    chips, channels 4/12/20/28. Every other input is wired straight to ground
    rather than through a pull-down. BRINGUP said "each input gets a switch to 3V3
    and a 10k pull-down", which described an intended rig, not the built one.
    This matters for the pinout caveat. Pins 3, 4, 5, 6 and 13 are not merely
    untested, they are untestable as wired -- hard-grounded inputs read 0
    permanently and produce no evidence either way. Confirming them needs a button
    moved or a ground lifted, so the caveat now says so instead of implying a press
    would settle it.
    Also records that all four bu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
2026-08-08 docs: '165 pin 6 (H, channel 0) confirmed by button press
    A button moved onto U1 pin 6 gave raw [10000000 ...] and tog [T------- ...] --
    exactly one channel, no neighbours. Channel 0 is the only channel whose capture
    timing differs, being the bit /PL presents before any clock arrives, so reading
    it correctly is direct evidence that CPHA=0 catches the pre-clock bit. Every
    other channel can only establish that by inference from frame alignment.
    Remaining unconfirmed pins are 3, 4, 5 and 13 (E, F, G, C), and the rig cannot
    exercise them as wired -- they are hard-grounded, so they read 0 permanently.
    Also records two bench traps that produced a false result first time round:
    - A first attempt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
2026-08-08 docs: last stale mode-2 claim, and record 4 MHz on 74HC165
    CHAINING.md still carried "Reasoned, not yet measured" for mode 2 -- missed
    because the earlier sweep was case-sensitive and the heading capitalised it.
    Replaced with the measurement, including the channel-0-via-H result that
    settles CPHA directly rather than by inference.
    Separately, five places capped 74HC165 at 2 MHz, but the bench rig has run the
    whole validation at 4 MHz on a breadboard for millions of frames with zero read
    errors. The descriptive docs now record that. The guidance is not simply
    relaxed: what fails first at eight modules is multi-drop CLK integrity across
    800 mm, a harness-length problem rather than a part-spee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
2026-08-08 HW-3: relax 74HC165 ceiling from 2 MHz to 4 MHz
    Measured basis: a 4-chip breadboard rig (2 modules, 32 ch) at 3.3 V ran the
    whole rev D validation at 4 MHz for millions of frames with zero read errors --
    mode 2, bit order, chain handoff, HW-11 self-termination, hot-plug recovery and
    channel 0 via input H were all established at that rate.
    The old figure had also been contradicting the shipped firmware: PINLED_SPI_HZ
    has defaulted to 4000000 all along, with Kconfig help explaining why 2 MHz is
    too slow (a 128-channel frame is 81 us at 2 MHz, which the boot check clamps
    below the 10 kHz target; at 4 MHz it is 49 us and fits). The requirement and the
    default now agree.
    Scope: this ceiling is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
2026-08-08 docs: drop the MCP23S17 study, fold its verdict into DOSSIER
    The file was deleted during the rev D work but the deletion was never
    committed, while TIMING.md and DOSSIER.md both still cited it by filename.
    Committing the deletion alone would have left two dangling references.
    Its rejection rationale now lives inline in DOSSIER.md section 3, expanded from
    the one-paragraph summary that was there to the full four reasons. Two of them
    were recorded nowhere else:
    - Sample skew: read serially, ch 0 and ch 127 land ~160 us apart, against rev
    C's 35 us spread and rev D's single capture edge.
    - The revival condition: queueing all eight reads with spi_device_queue_trans()
    so the driver's ISR ch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
2026-08-08 M1b complete: /PL held low tracks channel 0 live (FR-DIAG-3)
    A PINLED_SCAN_HOLD_CH=0 build on the 4x '165 rig logged DATA=0 at idle, DATA=1
    for the ~24 s the channel-0 button was held, and DATA=0 on release. One clean
    transition each way, no chatter, and no clocking involved -- the registers stay
    transparent and follow the input, which is what FR-DIAG-3 claims and what rev C
    had no equivalent of.
    The rig was already wired for it: the button had been moved to U1 pin 6 for the
    channel-0 pinout check, and pin 6 IS channel 0.
    That was M1b's last open item. All four diagnostics (FR-DIAG-1..4) are now
    exercised on real hardware, so the outstanding list no longer contains anything
    the bench rig c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
2026-08-08 docs: flag SCR holding current as a front-end constraint, not a power estimate
    Jefferson's bench chain is now complete -- Alltek Ultimate MPU + Ultimate Test
    Card + two Bally lamp driver boards (AS-2518-52 Aux Rev 3, and NVRAM's
    replacement LDB Rev 16) -- so real lamp drive can be tapped at a real socket.
    Looking at those boards surfaced a design question these docs have never
    answered: does the original incandescent stay in the socket? On a
    transistor-driven machine that is a power question. On SCR-latched Bally/Stern
    it is a functional one. An SCR conducts only while its load draws holding
    current, which a ~250 mA incandescent supplied for free. Replace it with a
    high-impedance sense tap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
2026-08-08 docs: front end carries jumper-selectable phantom loads and half-wave rectify
    Documents what was already the design intent but had never been written down.
    The original incandescent is removed -- that is the entire point of the product
    -- which makes the module front end responsible for two electrical jobs the
    bulb was doing for free:
    1. SCR holding current. Bally/Stern-era drivers latch with SCRs that conduct
    only while their load draws holding current. A ~250 mA bulb supplied it; a
    sense tap does not. Known field fix is ~470 ohm across the socket, ~13 mA at
    6.3 VAC.
    2. Supply regulation. The lamp rails are unregulated and specified under load.
    Strip most of the load out and th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
2026-08-08 docs: specify the configuration UI, profile sharing and OTA
    Web config portal, Wi-Fi provisioning and OTA were listed as out of
    scope. They are now specified, with the governing constraint that the
    cloud is a convenience and never a requirement — every function of the
    product is reachable with no internet connection.
    New docs/WEBUI.md covers the architecture and the reasoning behind it:
    - The SPA *shell* is served from the device; the bundle, images, help and
    registry content load from S3. The device makes no outbound calls at
    all. This split is forced by mixed-content rules — an HTTPS page cannot
    fetch HTTP, so a cloud-hosted SPA would require per-device TLS certs
    and ACME on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
2026-08-08 docs: install config is private, not device-bound; add snapshots
    "Never leaves the device" was the wrong granularity for the install
    config. It is ordinary user data — exportable, importable, and backed up
    to the user's private cloud area so a build survives a dead board. What
    it must never do is enter the *shared* registry, since it describes one
    physical build. The restriction that genuinely holds relocates to a
    single field: Wi-Fi credentials stay in NVS and appear in no export at
    any privacy level, so a restore implies re-provisioning.
    Adds snapshots (WEBUI.md 3a) for backup and A/B testing: a named,
    timestamped capture of the install config and machine profile *together*,
    with parent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
2026-08-08 docs: versions live off the device, not in a snapshot store on it
    Two corrections. Only one configuration can be in effect at a time, so a
    version library in the device partition is dead weight and a second thing
    to keep consistent — the device now stores exactly one active install
    config and machine profile, with no history. Versions are managed by the
    SPA and live where the user's other data already does: their private
    cloud area, or plain JSON files on local disk for the offline path.
    And A/B did not call for instant switching, only easy flipping with easy
    fallback. The hot/cold field table and the live-apply requirement are
    dropped. Flipping is an ordinary config write; the device onl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
2026-08-08 docs: add a working UI mockup as a design reference
    docs/ui-mockup.html is a self-contained page — no build step, no network,
    no dependencies — simulating the configuration UI specified in WEBUI.md.
    Its job is to make those decisions arguable before any of them is built:
    the learn-wiring flow, the machine-profile/install-config split, per-lamp
    presentation, versions, and OTA arming.
    The channel grid runs the same leaky integrator the firmware does, with
    the per-lamp attack/decay applied, so changing a fade shows the
    reconstruction behaving rather than a mock of it. Drive class is drawn as
    a waveform rather than a coloured chip: a class *is* a waveform, it reads
    faster than a legend, and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
2026-08-09 docs: protobuf on the wire, JSON where people read it; plan M3 in order
    Settles the M3 implementation decisions.
    A single .proto is the schema authority. Device traffic and on-device
    storage are protobuf via nanopb, so the firmware carries no JSON parser
    at all — no DOM parse of a 16 KB document on a 512 KB SRAM part. The
    browser converts to and from JSON for files, sharing and diffing, using
    proto3's canonical JSON mapping, so the readable form is generated from
    the same schema rather than separately maintained and free to drift.
    This also makes the FR-UI-4 version window rigorous rather than hopeful:
    field numbers and unknown-field preservation are exactly the mechanism a
    cloud-updated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
2026-08-09 docs: M3 runs on the bench QT Py, on a branch
    Drops the recommendation to move M3 to the DevKitC-1. The rig is wired
    and working; it is not being rebuilt to suit a milestone.
    The concern that prompted it — keeping a known-good diagnostic build
    available while the config work proceeds — is handled by a branch. The
    step-0 partition table is deliberately compatible with the current build:
    2 MB factory holds the existing app with room, so the table is flashed
    once and switching between builds afterwards is an ordinary app flash,
    with no table thrash or re-erase.
2026-08-10 M3 step 1: the schema, and a host test rig that runs
    proto/pinled.proto is the schema authority (FR-CFG-13) — machine profile,
    install config, version, device API and the live frame. It carries the
    compatibility rules in the header comment, because they are what makes
    FR-UI-4's version window real rather than aspirational: never reuse a
    field number, never change a type, burn removed numbers as reserved, and
    a zero value must always mean "as before". No floats anywhere; the
    firmware is fixed-point and a float on the wire invites the two
    implementations to drift.
    pinled.options bounds every string and repeated field so nanopb can
    generate static structs with no malloc, and records the arit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
    [harness.h, pbtool.py, test_crc32.cpp, test_doc_frame.cpp]
2026-08-10 M3 step 1 complete: schema round-trips against a second implementation
    Finishes step 1. protoc 3.21.12 is now installed on intel-nuc.tworivers,
    with a venv at ~/.venvs/pinled-tools (protobuf, nanopb) and the nanopb C
    runtime cloned to ~/.local/src/nanopb pinned at 0.4.9 — the pip package
    ships the generator only.
    38 cases green on the build host: 8 CRC, 17 frame, 13 schema.
    The schema suite is a CROSS-IMPLEMENTATION check, which is the whole
    reason it is worth having. The .pb fixtures are encoded by Google's
    protobuf and decoded here by nanopb; nanopb agreeing with itself would
    prove nearly nothing, whereas nanopb agreeing with the reference
    implementation is evidence the .proto is unamb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
    [machine_profile.json]
2026-08-10 M3 step 2: the two config models and the projection between them
    The document model is the GENERATED nanopb struct. No hand-written
    parallel class tree: a second definition of the same schema is a second
    thing to keep in step, which is exactly what having one schema authority
    (FR-CFG-13) is meant to prevent.
    The runtime model is ChannelConfig — 14 bytes, POD, no pointers, no
    strings, static_assert'ed on its size because the render path reads it
    every frame and NFR-4 bars allocation there. It carries no lamp names:
    nothing in scan or render has ever needed one, and leaving them out means
    GET /profile can verify the stored CRC and stream the payload straight
    back WITHOUT decoding, so names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
    [test_resolve.cpp]
2026-08-10 M3 step 3: configuration reaches the pipeline, and locks are honoured
    This step was scoped wrongly in the plan and the correction is most of
    the story. Filament::set_params(ch, ...) and LampMap::set_entry(ch, ...)
    already existed, and profile_boot() already called the former per
    channel — it was never an API change across three components. The real
    gaps were narrower:
    * set_entry was never called by ANYTHING. LampMap::init() calls
    set_default_mapping() and that was the end of it, so per-lamp colour
    had nowhere to enter the system.
    * class_lock was not honoured: profile_boot() overwrote every channel
    with the classifier output, locked or not.
    * nothing carried a resolved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
    [lamp_map.cpp, main.cpp, main.h]
2026-08-11 M3 step 4: the configuration store
    Two documents on a LittleFS partition, and the boot path reads them. Step 0's
    partition table comes with it: factory 1M -> 2M plus a 1536K storage
    partition, sized so the table is flashed once and both this build and the
    known-good diagnostic build on main are thereafter ordinary app flashes.
    The store is written against <cstdio>, not an ESP-IDF file API. LittleFS is
    reached through VFS, so fopen("/cfg/install.pb") is the real interface on the
    target -- which means the whole of pinled_doc_file is host-testable against a
    temporary directory, with genuinely truncated and genuinely corrupt files
    rather than simulated ones. Only the mount is target-specific.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
    [partitions.csv]
2026-08-11 The strip is RGB-ordered: byte order becomes an install setting
    Step 4's fixture displayed the first saturated colour this firmware has ever
    shown, and it came out wrong: channel 0 asked for pure red and lit green,
    channel 4 asked for green and lit red. WS2812B is GRB and the driver emits
    GRB; the bench strip is one of the RGB-ordered clones, which carry identical
    markings and are sold as the same part.
    The reason this survived so long is that the failure is quiet. A near-white
    tint through a swapped pair is still a near-white tint, so the default
    {255, 200, 140} looked correct for the entire life of the project. Only a
    saturated colour can reveal it. One of the new tests states this outrig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
    [lamp_map.cpp, lamp_map.h, main.cpp, pinled_resolve.cpp, test_color_order.cpp]
2026-08-12 M3 step 5: the device API
    esp_http_server on /api/v1 with info, config and profile, plus the network to
    reach it on: station mode when Kconfig credentials are set, SoftAP otherwise,
    and mDNS so pinled.local resolves. Both modes now rather than SoftAP alone,
    because step 7 needs both anyway and a stopgap with no successor tends to
    become the design.
    GET returns the STORED BYTES, unmodified. The CRC is verified and the payload
    copied out without ever being decoded, which is what makes the FR-UI-4
    version window real rather than aspirational -- a document written by a newer
    SPA carries fields this build has no struct for, and re-encoding would drop
    every one. It also means GET /profile never m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
    [main.cpp, main.h, net.cpp, net.h, pinled_resolve.cpp]
2026-08-12 M3 step 6: the live WebSocket
    /api/v1/live carries a LiveFrame at ~30 Hz: two bytes a channel, level and
    flags, with DriveClass in bits 2-4. Plus a pbtool `live` subcommand -- a
    sixty-line WebSocket client rather than a dependency -- so there is a way to
    watch it before any UI exists.
    THE HAND-OFF IS THE DESIGN. The scan accumulates activity into plain local
    words -- no atomics in the 10 kHz inner loop -- and publishes with four
    fetch_or per frame; the push drains with exchange(0). That pairing is what
    makes the race benign: a set landing before the drain is reported now, one
    landing after survives to the next push. A plain load-then-store on the drain
    side would swallow anything set in bet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
2026-08-12 M3 step 7: provisioning and the captive portal
    SoftAP with a self-contained setup page, credentials to NVS, and two ways
    back: a button held five seconds, and DELETE /api/v1/provision for the UI.
    Plus POST /api/v1/provision, GET /api/v1/scan, a DNS hijack, and the probe
    URLs each OS uses to decide a network is captive.
    WRITTEN DIRECTLY RATHER THAN WITH wifi_provisioning, and the plan was wrong
    about that. wifi_provisioning speaks protocomm -- protobuf over a custom
    endpoint with an X25519 + AES-CTR handshake, built for Espressif's phone app.
    FR-UI-6 wants a page self-contained ON THE DEVICE, so the component would
    have meant hand-writing that client in JavaScript with crypto: it saves
    writi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
    [credentials.cpp, credentials.h, dns_hijack.cpp, dns_hijack.h, lamp_map.cpp, lamp_map.h, main.cpp]
2026-08-13 M3+: the profiler re-arm, and the window in milliseconds
    Two requirements that turned out to be one change.
    FR-PROF-2: classification only ever happened at boot, on a playfield that
    was switched off, so every channel came back OFF and the live monitor has
    faithfully reported a dead machine ever since step 6. POST /api/v1/profiler
    re-arms it, and so does a short press of the button already on the board.
    FR-PROF-5: the window was 512 fixed frames, which at the boot free-run rate
    is about 14 ms -- under two mains half-cycles. It is milliseconds now, and
    the frame count derives from the MEASURED Fs like every other time constant.
    The structural part is that there is one way to produce a class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
    [main.cpp, main.h]
2026-08-13 pbtool: a class view for the live socket
    Activity comes and goes at 30 Hz and is hard to read; the DriveClass is a
    standing answer that changes only when a profiling pass completes. Printed
    on change only, so a re-arm is one new line in a still terminal -- which is
    the difference between watching for it and hunting for it.
2026-08-13 docs: step 8, and the bench checklist the re-arm needs
    The verification that matters -- a held channel reading OFF before a re-arm
    and STEADY after -- cannot be done from a wired build host, so it is written
    down as seven steps rather than left as an intention. Step 4 (release, re-arm,
    expect it to go back) is the half that makes it a test: a class that only
    moves one way would pass 1-3 while being a latch.
    Also records the IDF activation trap, which cost a build cycle: export.sh
    fails on this host and names a missing venv rather than the real mistake.
2026-08-13 review: make an abandoned profiling pass safe, and stop pbtool crashing on an unknown class
    F1: the profiler is only fed from a good scan frame, so a persistently
    failing read_frame left the phase OBSERVING for the life of the boot and
    every later request refused with 409 -- on a device whose real problem was
    elsewhere and diagnosable. service_profile() now abandons a window that has
    outlived its budget.
    That fix needed the state machine to carry pass identity, not just phase.
    Phase and pass number now live in one word and every transition is a
    compare-exchange on the whole thing, because the scan task decides whether to
    arm by asking 'is this a pass I have not seen'. With them separate, tw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
    [main.cpp, main.h, pbtool.py]
2026-08-14 docs: the locked channel is a free assertion, not noise
    Channel 20 (U3.D) classifies AC_STEADY because fs_seed locks it, which I
    first read as a noisy input. Turning that into a checklist step instead: a
    re-arm that ignored the lock table would pass every other step here while
    quietly overwriting each hand-set lamp on a playfield. Channel 20 holding
    its class through a pass that reclassifies its neighbours is the evidence
    it does not, and the bench profile already provides it.
2026-08-14 live: keep draining while nobody is connected
    The scan publishes into the sticky bitmap whether or not anyone is watching,
    but the push task skipped snapshot() with no clients -- so the bits piled up
    for the whole gap between sessions and the FIRST frame of a new connection
    reported activity that could be minutes old.
    Found while answering a question about a dark LED: channel 20 arrived
    active=True on frame one and False on every frame after, having been quiet
    for the twenty seconds I then measured. A ghost lamp is a bad first
    impression and a worse thing to debug, and it would have put a phantom in
    step 1 of the bench checklist.
    'Sticky since the last push' has to mean the last push, not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
    [test_live.cpp]
2026-08-14 main: one run loop, so SCAN_DEBUG cannot change profiler behaviour
    The bring-up build had a loop of its own that slept for 500 ms instead of
    waiting on the notification, so a re-arm landed up to half a second after its
    window closed rather than immediately. That would be a minor wart except for
    which build it was: SCAN_DEBUG defaults to y and the bench runs it, so every
    re-arm measurement yesterday came from the poll path and the notification
    path -- the one the comment describes -- had never executed on hardware.
    Measured now, with SCAN_DEBUG off: request at 18211 ms, classified at 18961,
    applied at 18962. One millisecond after the window closes, against 70-115 ms
    through the poll. Yesterd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
2026-08-14 docs: correct the re-arm latency, and why it was wrong twice
2026-08-14 bringup: HW-1 measured on a bench for the first time
    The old rig wired buttons straight to 3V3 with pull-downs and had no front
    end, so the shipping topology was design-only. With 2N7000 into 74LVC14 on
    the five test channels: idle all zeros, each press landing on its own channel
    with no neighbours, active_low still off. The Schmitt's hysteresis being
    present also makes the profiler's edge counts trustworthy for the first time
    (TIMING.md 5.4).
    Records the FET-without-Schmitt symptom, because it is a believable shortcut
    and the fix people will reach for is wrong: active_low is one global XOR, so
    it corrects five channels, inverts twenty-seven, and flips the sense of
    HW-11's self-termination.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
2026-08-15 tools: the re-arm checklist as a script
    BRINGUP.md section 5b was eight steps of prose that needed a person to hold an
    input and a second person, or a lot of patience, to drive the API in step. This
    drives the API and the live socket itself and stops to ask for the four presses
    that genuinely need hands.
    Exits non-zero on any failure so it can gate rather than be read. The rescue
    step is opt-in because it wipes the stored network.
    [rearm_check.py]
2026-08-15 rescue: a click should re-arm, and a press too short should say so
    Step 5 of the section 5b checklist failed on the bench and the button was
    fine. Three graded presses proved it: a tap logged nothing at all, a ~0.7 s
    press re-armed, a ~2.2 s press counted down and then re-armed on release.
    Two faults, both mine. The threshold was 300 ms, which is LONGER than most
    people press a button for, so an ordinary click was ignored. And a press
    below it produced no countdown, no callback and no log line, so "pressed it
    too quickly" and "the button is dead" were the same observation.
    Now: poll at 20 Hz rather than 10 (at 10 Hz a click can fall entirely between
    two samples), threshold 150 ms so a norm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
    [rearm_check.py, rescue.cpp]
2026-08-15 bringup: first long-run frame-loss measurement
    4.2 hours of uptime, 6000 scan overruns, 0.004 percent -- about 1 frame in
    25000, at a steady rate rather than an accelerating one. Negligible against a
    30 ms attack constant, but worth recording because every previous capture was
    seconds to minutes and the counter had never had the chance to report
    anything at all.
    Not attributed. SCAN_DEBUG was on and its per-frame array writes are a
    plausible contributor, as are Wi-Fi interrupts; separating them needs an A/B
    nobody has run.
2026-08-15 docs: step 8 verified on the bench, 11/11
    The claim a wired build host cannot make -- that classification tracks what
    the machine is doing -- now has evidence: a held channel reclassifies off to
    steady, returns on release, the locked channel survives the same pass, and a
    button click re-arms as the API does.
    Records that the checklist did not catch what it was aimed at. The classifier
    and its three-task hand-off worked first time; both bugs were in the parts
    that looked trivial, and both were the same mistake.
2026-08-15 bringup: the clock sweep judged an all-zero chain as perfect
    Two holes, and the second is the one that would have mattered.
    With no input held the chain reads all-zeros at every rate. Every frame
    matches every other, so the old sweep printed 'stable 256/256' from 1 MHz to
    40 MHz and a reader would conclude the bus was clean at 40 MHz having proved
    nothing at all. Zero examined is not a pass; it now says so and refuses to
    count the rate.
    And each rate was only ever compared against itself, so a rate the chain
    cannot follow -- which reads the SAME WRONG BITS every frame, because a
    dropped bit shifts the whole frame by one channel -- also scored perfectly.
    The slowest working rate is now the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
    [main.cpp]
2026-08-15 bringup: LVC165 sweep result, and what a sparse pattern does not prove
    Every rate matched the reference from 1 to 40 MHz -- 96 measurements, 24576
    frames, one pattern throughout. 40 MHz is the ESP32-S3's ceiling through the
    GPIO matrix, so this found the MCU's limit rather than the part's; the HC
    parts were qualified at 4 MHz.
    Recorded with the caveat that matters: 28 of 32 inputs are grounded and one
    is tied high, so DATA carries two transitions in a 32-bit frame. That covers
    clock, capture instant, chain traversal and frame alignment, and covers
    nothing at all about signal integrity, whose stress case is 10101010 with
    DATA toggling at half the clock through a 33R series resistor on a
    brea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
2026-08-15 8 MB board: two OTA slots, and a boot banner that names the build
    Partition table for the FN8C0: nvs, otadata, phy_init, ota_0 3M, ota_1 3M,
    storage 1.875M, ending at 0x800000 exactly. 3 MB a slot against a ~955 KB
    image is deliberate -- the slots are the thing that cannot be resized without
    erasing everything, so they get the slack. No factory partition: with none
    present and otadata blank the bootloader runs ota_0, which is where idf.py
    flash writes, so an ordinary flash behaves as before.
    THIS BUILD NO LONGER FITS THE 4 MB FH4R2. The two QT Py variants share a
    silkscreen and a USB VID/PID, so sdkconfig.defaults now says which board is on
    the bench and what happens if you get it wrong.
    T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
    [partitions.csv]
2026-08-15 bringup: the 8 MB board swap, and correcting the USB-identity claim
    Done once, and the table change was the easy half. A factory-fresh Adafruit
    board refuses DTR/RTS entirely -- Errno 71 on any port open -- so download mode
    has to be entered by hand; and entering it by hand latches a flag that survives
    the flash's own reset, so the board comes back into download mode looking like
    firmware that never started. Only a USB replug clears it.
    Corrects sdkconfig.defaults, which claimed both QT Py variants share
    239a:8143. Measured: the FN8C0 reports 239a:8119 with Adafruit firmware, and
    once ours is flashed both report 303a:1001, so USB identity does not identify
    the variant at all. esptool flash_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
2026-08-15 bringup: record what the 8 MB swap verified, including FR-UI-7
    11/11 on rearm_check.py --include-rescue -- the section 5b checklist plus the
    destructive step it normally skips.
    The long-hold rescue is the one that mattered: rescue.cpp had changed twice
    since it last ran, for the short-press callback and then for the 20 Hz poll
    and 150 ms threshold, and nothing had re-exercised the erase path. The full
    countdown, the erase, the SoftAP and the reprovision are all in the log.
    Splitting one button between two jobs by duration did not break either.
    Also confirms the profiler and live monitor behave identically on the FN8C0:
    same window, same frame count, 30.2 Hz with no gaps, locked channel sti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
2026-08-15 docs: retire claims that today made false
    Three stale spots, all of them things a reader would have acted on.
    WEBUI.md section 7 said the 8 MB table was 'not yet applied'. It is, exactly
    as written, and it cost the re-provision that note predicted. The same note
    claimed both QT Py variants share USB 239a:8143 -- measured, the FN8C0 reports
    239a:8119 under Adafruit firmware and 303a:1001 under ours, as does every
    other ESP32-S3, so USB identity describes the running firmware rather than the
    board and stops discriminating the moment you flash it. esptool flash_id is
    the check that keeps working.
    FIRMWARE_PLAN section 6 opened with 'None of this exists yet -- there is not a
    single test file i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
2026-08-15 design: OTA confirmed by the button, and a status pixel that makes it legible
    Two decisions that turn out to be one. Jefferson's idea: while a firmware
    image is pending, a short press of GPIO 0 confirms it instead of re-arming the
    profiler, reverting after a timeout. That needs no second button and no new
    gesture -- but a modal control whose mode is invisible is a trap, so the
    status pixel stops being cosmetic and becomes the thing that makes the button
    honest.
    FR-OTA-2 changes shape: confirm AFTER the upload rather than arm before it.
    Writing an inactive slot cannot hurt anything, so the act worth gating is the
    boot-partition switch. Arming first opens a window in which anything on the
    LAN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
2026-08-15 docs: close the lamp-numbering open question, which was never a schema question
    Jefferson pushed back on this and he is right. The indirection already exists:
    WiringEntry maps channel to lamp number privately, LampEntry maps lamp number
    to presentation shareably, MachineIdentity scopes what the numbers mean. The
    firmware only ever tests lamp for zero and for equality -- nothing parses
    structure out of it -- so Bally 1-60, a flattened Williams row/column and an
    EM game numbered from its manual are all just integers.
    What made it look urgent was 'it affects the schema'. That was the error: the
    only plausible change is ADDING an optional descriptor, and protobuf absorbs
    an added optional field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
2026-08-17 docs: close profile fit checking -- partial import, already implemented
    'Partial or refused' put the decision in the wrong layer. resolve() iterates
    channels rather than profile entries, and pinled_resolve.h already states the
    policy: lenient where a half-finished install is normal, strict where a value
    is ambiguous or impossible. The device refuses what it cannot represent and
    honours what it can partially apply.
    Refusing an incomplete profile would block the case that matters most --
    someone halfway through wiring who wants the lamp names to help them finish.
    lamp_count is not consulted by the firmware at all; it is UI metadata.
    What remains is a UI reporting decision: applying a profile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
2026-08-17 design: fault class numbering, press feedback, and shortfall reporting
    Three decisions, closing the last of the pre-M4 questions.
    Shortfall reporting: applying a profile shows how much of it landed and does
    not block. Partial is normal during commissioning and the number doubles as a
    progress readout. The device is not involved -- it has already applied what it
    could, and the UI holds both documents, so this is arithmetic the browser does
    and needs no API change.
    Fault classes group by the subsystem someone can act on rather than by where
    the error was raised, and are ordered by expected frequency, because a count is
    only useful if it is easy to read and the common ones get read most. Coun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
2026-08-18 docs: retire three stale claims and order M4
    BRINGUP §7's superseded-rev-C list still said SPI mode 2 "is unverified"
    and still asked for the clock sweep to be re-run. Both were done on the
    rev D rig -- mode 2 measured 2026-08-06/07, the sweep run on 74HC165 and
    again on the SN74LVC165 rebuild (§4b). A list of things not to carry
    forward is exactly where a stale claim survives longest, because nobody
    re-reads it looking for current fact.
    FIRMWARE_PLAN §8 still listed the three design questions M4 was waiting
    on as open, including the arming-gesture snag that the context-dependent
    short press closed. All three closed 2026-08-16.
    Added §5.2, M4 in order, on the same two principles as §5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
2026-08-18 feat(indicator): the pattern generator, host-testable
    A state and a handful of elapsed-millisecond counters in, a colour out.
    No IDF, no timer, no LED, no clock of its own -- which is what makes the
    fault counting, the two accelerating countdowns and the overlay
    precedence assertable by stepping a number instead of holding a button
    and counting out loud in a dark backbox.
    The fault class enum value IS the blink count. There is no lookup table
    to keep in step with REQUIREMENTS' table, which is the failure mode a
    table would have.
    Overlay precedence is the part worth arguing with, and each step of it
    is a requirement rather than a preference: the hold ramp outranks
    everything because it is a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
    [test_indicator.cpp]
2026-08-18 feat(indicator): drive the pixel, and report the button live
    The thin half: a component that owns the pin, the task and the clock,
    and calls the pure generator for everything it shows.
    Three things here are decisions rather than plumbing.
    **Transmit only on change.** The task runs at 100 Hz -- fast enough that
    an 80 ms press blip is never missed, which is the whole value of
    FR-IND-7 -- but a healthy machine is one steady colour for months, and
    an unconditional write would be 100 RMT transactions a second to say
    nothing.
    **Absolute instants, not elapsed times.** Every setter is a single
    relaxed store and none of them has to know what "now" is (FR-IND-6);
    the task subtracts. 0 -- what these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
    [indicator.cpp, indicator.h, main.cpp, main.h, rescue.cpp, rescue.h]
2026-08-18 fix(indicator): cast the atomic state back to its enum
    [indicator.h]
2026-08-18 fix(indicator): drive the status pixel over RMT, not I2S
    The board said this on the first boot after the last commit:
    W i2s_platform: i2s controller 0 has been occupied by i2s_driver
    zorxx/neopixel -- the component the playfield string uses -- is an I2S
    driver, not an RMT one, despite what my comments claimed. The ESP32-S3
    has two I2S controllers and four RMT TX channels, so reusing it for the
    status pixel spent the second of the scarce peripheral on one LED
    updated a few times a second, and left nothing for anything else that
    might want I2S.
    It worked. It was still the wrong half of the budget to spend, and the
    warning was the board pointing at it.
    Thirty lines of rmt_tx instead, with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
    [indicator.cpp, indicator.h, test_color_order.cpp]
2026-08-18 docs: the status pixel's bench checklist, and what it cannot yet show
    BRINGUP §5d. The indicator is the one part of this firmware whose
    correctness cannot be read off a log -- the log says what the generator
    was asked for, and the question is what a person at the board sees --
    so the eight steps here are all eye and hand, with the pattern
    generation itself already covered by 31 host cases.
    Steps 5 and 6 have to be run together and the checklist says so. A blip
    that fired on every press including the ones too short to act on would
    answer nothing, and silence on every press would answer nothing either;
    what makes it useful is that it fires exactly when the press was
    accepted.
    Also recorded,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
2026-08-18 feat(config): the status pixel brightness, stored (FR-IND-5)
    A new StatusIndicator message in InstallConfig, field 8. Its own message
    rather than a RenderConfig field because presence is the encoding:
    FR-IND-5 requires off to be a setting, so brightness is literal and 0
    means dark — while the append-only rule's 'zero means as before' is
    carried by the message, whose absence inherits the build default.
    CONFIG_PINLED_STATUS_BRIGHTNESS is demoted to that build default: the
    pixel still starts on it at step 0 (it must exist before the store can
    fail), and the stored value takes over the moment load() returns.
    [machine_config.cpp, main.cpp, pinled_resolve.cpp, test_install.cpp]
2026-08-18 fix(indicator): two review findings on teardown and release feedback
    The button loop fired held(0) on every idle poll — twenty a second,
    forever — where the contract says once per release. Now it fires only
    when there was a press to release.
    Indicator::deinit() freed the RMT handles after a fixed 20 ms grace,
    while the task can sit inside a transmit whose completion wait is
    bounded at 100 ms. The task now reports its own exit as its last act,
    and deinit frees nothing until it has, with a 500 ms ceiling past which
    leaking beats freeing under a wedged task.
    [indicator.cpp, indicator.h, rescue.cpp]
2026-08-19 feat(ota): the staging state machine, host-testable (FR-OTA-2)
    Phase and generation in one word, the profiler's hand-off pattern:
    every transition is a compare-exchange on the whole thing, so a second
    upload during a pending window is a refusal rather than a silent
    replacement, and a stale expiry timer has no word left to retire.
    Confirmation loses to the deadline by rule (>= at the instant), and the
    expiry arithmetic is wrap-safe both ways: a window straddling the
    49-day wrap stays 30 s long, and an expired one does not come back
    confirmable 24.8 days later. All of it mutation-checked: five targeted
    mutants, five killed.
    [test_ota_state.cpp]
2026-08-19 feat(ota): the staging driver — stream, digest, expire, confirm
    OtaManager streams into the inactive slot behind the host-tested word:
    begin() claims the machine before touching flash so a competing upload
    is refused however far along it is; finish() checks the byte count and
    the optional SHA-256 of what actually arrived (FR-OTA-3's device-side
    backstop) before esp_ota_end() validates the image structure; the
    expiry timer and the button both resolve through the same pure
    functions, so their race has one deterministic winner.
    confirm() exists for the button task alone — the API can stage and
    discard, the harmless directions, but only a hand on the board makes
    it boot (FR-OTA-2). mark_run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
2026-08-19 feat(api): POST /ota stages, DELETE discards, the button decides
    The upload endpoint streams raw image bytes into OtaManager and
    answers with an ApplyResult: 409 while anything is in progress, 413
    past the slot, 400 for a hash mismatch or an unbootable image, and on
    success 'staged; press the button within N s'. There is deliberately
    no confirm endpoint — the API gets the harmless directions only
    (FR-OTA-2), which is what makes the open CORS policy safe here.
    X-Image-SHA256 joins the allowed CORS headers; pbtool gains 'ota' and
    'ota-discard', computing the digest client-side the way the SPA will
    check the published one (FR-OTA-3). DeviceInfo's never-true
    ota_armed/ota_arm_seconds_left are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
2026-08-19 feat(ota): wire the window to the button, the pixel, and rollback
    start_ota() runs before the API so no request can beat the manager to
    existence. The short press is now modal (FR-OTA-7, HW-16): confirm()
    outranks the profiler re-arm and referees its own race with expiry, so
    the callback needs no time awareness. The indicator hooks map staged to
    the accelerating blink, cleared to a re-settle (the window can expire
    into any of the three resting states), and applying to the amber beat
    before restart.
    CONFIG_BOOTLOADER_APP_ROLLBACK_ENABLE goes into sdkconfig.defaults, and
    the fresh image marks itself valid only once it is SERVING the API —
    FR-OTA-6 taken literally, because the API is the rec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
    [main.cpp, main.h]
2026-08-19 fix(ota): open the TCP window, and call a non-image a 400
    A megabyte through lwIP's default 5.7 KB receive window is a 4 KB
    window-update drip with persist-timer backoff between sips: measured
    ~17 KB/s on the bench and a stalled-upload 408 before the image ever
    finished. 32 KB of window (a cap, pbufs alloc on demand) with an mbox
    sized to hold it is the standing cure.
    esp_ota_write rejects a wrong magic byte on the first chunk; that is
    the uploader's mistake, not a flash failure, so it now answers 400
    'not a firmware image' instead of a 500.
2026-08-19 docs: OTA's bench checklist, and the otadata flashing trap
    §5e records what the container could verify (staging speed, the 409,
    expiry at exactly +30 s, both 400s) and hands the button half to the
    bench: confirm boots ota_1 and cancels rollback, the staged press must
    NOT re-arm the profiler, the long-hold rescue outranks everything.
    Rollback itself is flagged honestly as believed-not-measured, with the
    broken-image recipe for whoever wants to measure it.
    §6 gains the trap this table now makes possible: after a confirmed OTA,
    idf.py flash writes ota_0 while the bootloader boots ota_1, and new
    code silently has no effect until erase-otadata.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
2026-08-19 feat(api): report the running slot in /info
    DeviceInfo gains running_slot ("ota_0"/"ota_1") so a confirmed OTA is
    checkable from the API, as §5e step 6 already promised — until now the
    only evidence was the boot log's load offset.
2026-08-19 feat(api): per-build identity in /info
    DeviceInfo gains build_id, the first 16 hex chars of the app ELF
    SHA-256. firmware_version only bumps at release, so during OTA testing
    two builds were indistinguishable from the API — and the compile
    timestamp is worse than nothing, since incremental builds keep a stale
    one (two different images on the bench claimed the same compile time).
2026-08-19 docs: OTA confirms into the other slot, not ota_1
    The checklist implied a confirm always lands in ota_1, which is only
    true starting from ota_0 — consecutive OTAs ping-pong, and the bench
    read a successful second confirm (into ota_0) as a failure. Point
    step 6 at running_slot/build_id in /info while here.
2026-08-19 fix(net): survive the join-failed fallback to the SoftAP
    A provisioned board that cannot reach its network falls back to the
    portal — but start_softap unconditionally created the default STA
    netif that the failed join had already created, which is an assert
    inside ESP-IDF and therefore a boot loop, forever, on exactly the
    board that most needs to be reachable. Found on the bench 2026-08-19
    by the §5e hold-while-staged check followed by provisioning to an
    unreachable network; latent since step 7, because no join had ever
    failed six times before.
    The portal only needs a station interface for scanning, so the
    existing one serves. The WIFI_EVENT handler is now also registered
    exactly once, s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
    [net.cpp, net.h]
2026-08-19 feat(schema): the author-handle rule, and its message (FR-REG-1)
    AuthorHandle carries the one string; the validity rule — 1-31 bytes,
    no control bytes, no edge spaces, UTF-8 passed through because
    encoding is the browser's job — lives in pinled_schema where the host
    tests it. Ownership and verification stay cloud-side, deliberately.
2026-08-19 feat(identity): the author handle in NVS, and nowhere else
    The same shape as credentials.cpp, in its own NVS namespace so the
    network-forget rescue cannot take the attribution with it (and vice
    versa). Load reports empty-and-NOT_FOUND on a fresh device, which is
    the ordinary state, not an error.
2026-08-19 feat(api): PUT and DELETE /author, and /info reports the handle
    M4 step 3 (FR-UI-4, FR-REG-1): the API version, device id, running
    slot and build id were already in /info; this adds the last piece —
    storing the attribution handle, with no restart because nothing
    running reads it. send_ota_result becomes send_apply_result now that
    two endpoints share it. pbtool grows an author command, and the
    WEBUI.md endpoint table is updated from aspiration to the shipped
    contract.
2026-08-19 docs: step 3 landed — the bench results in the plan
2026-08-19 fix(api): pin the handle bound to the schema field sizes
    kAuthorHandleMax and the two 32-byte schema fields are one number in
    three files, previously tied by comments alone; drift would truncate
    or wrongly refuse, silently. Two static_asserts where all are visible.
2026-08-19 feat(web): the SPA's wire layer, proven against the board
    protobuf.js (vendored, BSD-3) parses the .proto text at runtime — one
    schema authority, no generated bindings to drift (FR-CFG-13); the text
    ships inside a classic script because file:// (FR-UI-8) can fetch()
    nothing. api.js carries the whole device surface plus a pure-JS
    SHA-256, because an http:// origin is not a secure context and
    crypto.subtle does not exist there. Snake_case JSON imports are
    translated, so pbtool files and canonical files both load.
    test/web/api_check.js runs the same api.js under node against live
    hardware — 17 checks: digests against node:crypto, every GET decoding,
    the document encode/decode and JSON-file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
    [gen_proto_js.py]
2026-08-19 feat(web): the app itself — five panels against the real board
    index.html and app.js implement the mockup's design against the live
    API: the channel map painted from 30 Hz frames with the sticky bit,
    the learn-wiring flow (type the lamp you fired, click the cell that
    lit), the inspector writing profile entries, lamps and install views,
    JSON import/export for both documents plus a paired Version file, and
    the device panel — identity, author handle, profiler, and the OTA
    upload with the staged countdown and only-the-button messaging.
    Edits stay in a working copy until Apply & restart, because applying
    is write-then-restart (FR-CFG-16); the apply reports the profile/
    wiring shortfall rathe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
2026-08-19 feat(api): the SPA shell on GET / (FR-UI-1)
    '/' becomes modal on the network state: an unprovisioned board keeps
    the setup portal, a provisioned one serves the shell — a page on the
    device origin (the only origin that may call an http:// API) that
    pulls the app bundle from PINLED_BUNDLE_URL cross-origin. No bundle
    configured, or the fetch fails: the shell states it and explains the
    standalone file:// path, which is the offline story working as
    designed (FR-UI-8), not a degraded mode.
2026-08-19 fix(web): absent document sections read 'build default', not 0 Hz
    Found by the headless DOM run: the stored install config legitimately
    omits scan/render/pins (absence inherits the build default, the
    append-only rule), and the install cards rendered that as '0 Hz' and
    'GPIO undefined' — a configuration nobody wrote. Plus the bench docs:
    §5f checklist for the eyes-and-test-card half, and the step-4 status
    note in the plan.
2026-08-19 docs: record the owner's future feature list (WEBUI §9)
    Multi-LED channels, multi-channel LEDs, colour-to-colour fades, and
    lamp/channel groups — stated 2026-08-19 after the first live mapping
    session, recorded as intent ahead of design. All additive to the
    schema.
2026-08-20 fix(render): linearise base colours — the swatch you pick is the colour you get
    Profile colours are sRGB bytes off a screen swatch, but WS2812 PWM is
    linear light: 178 on a screen is ~45% luminance, 178/255 duty is 70%.
    Feeding swatch bytes straight to the strip overdrove every mid-range
    component — deep red rendered pink, amber pale yellow — found by the
    first real mapping session 2026-08-20. Pure 0 and 255 are gamma's
    fixed points, which is exactly why the primary-colour byte-order test
    looked perfect while mixed colours were wrong.
    Base colours now pass through an x^gamma LUT once at set_entry (and
    for the default tint), using the same gamma the filament level LUT
    already uses —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
    [lamp_map.cpp, lamp_map.h, main.cpp]
2026-08-20 feat(colorlab): pin one LED to exact bytes, live — the colour harness
    'The colours are not right' was undebuggable through the
    press-apply-restart loop, so this is the instrument the owner asked
    for: POST /api/v1/colortest pins any LED to exact bytes every frame
    (a packed-atomic override in the renderer, cleared by DELETE or
    reboot; nothing persists), with a raw flag that bypasses the
    sRGB->linear conversion so the conversion itself can be A/B'd at the
    strip. pbtool grows a colortest command; the app grows a Colour lab
    card and a per-channel Preview-on-LED button.
    [lamp_map.cpp, lamp_map.h, main.cpp, pbtool.py]
2026-08-20 feat(colorlab): a gamma sweep, because neither endpoint of the A/B won
    The bench verdict on raw-vs-linearised was 'sometimes one, sometimes
    the other, and mid colours tend toward white' — so the truth is
    between the endpoints, and a binary A/B cannot find it. ColorTest
    gains gamma_x100 (0 = the device's configured gamma; the conversion
    happens per-request in the handler, so the renderer grows no pow());
    the app's lab replaces the raw checkbox with a gamma slider that
    re-pins on release, the level slider defaults to 128 because a bare
    LED at full power blooms the eye toward white regardless of bytes,
    and pbtool grows --gamma. The winning value becomes
    render.gammaX100 in the install config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
    [pbtool.py]
2026-08-21 docs: HW-9 stopped being theoretical — the colour cliff was V_IH margin
    The bench colour mystery reduced, via the colour-lab harness, to a
    deterministic hue flip at a bit-carry boundary: marginal-V_IH pattern
    corruption on a 3.3 V GPIO driving a 5 V strip, exactly as HW-9
    warned. Recorded with the Überguide's corroborating remedies
    (74AHCT125/74HCT245, or strip VDD < ~4.7 V, plus the data resistor
    and reservoir cap) so the mainboard BOM inherits it as a decision.
2026-08-21 fix(render): the strip driver bit-reverses every colour byte — compensate at the boundary
    A logic-analyser capture (raw/R0G255B0.csv, R0G254B0.csv) settled the
    colour mystery: the zorxx/neopixel 1.1.0 I2S path on this S3/IDF 5.5
    build transmits cleanly framed WS2812 data whose bytes are
    BIT-REVERSED — 0x80 in, 0x01 on the wire, palindromes unchanged. That
    one defect explains the whole arc with arithmetic: primaries
    (0x00/0xFF) always passed, deep red gained double blue and went pink,
    amber gained quadruple blue and washed white, (126,128,128) rendered
    (126,1,1) RED beside (128,128,128)'s dim-white (1,1,1), and green
    255-at-level-128 went out as 1 while 254 went out as 254. The status
    pix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
    [R0G254B0.csv, R0G255B0.csv]
2026-08-21 build: pin zorxx/neopixel to ==1.1.0 — wire8() compensates THIS version
    The shim reverses what 1.1.0 measurably reverses; an upstream table
    fix arriving silently through '*' would double-reverse and break
    every mixed colour again, in exactly the way that took a logic
    analyser to find once. The pin and the shim leave together, when the
    driver is replaced after feat/webui closes (led_strip, or in-house —
    the indicator's raw-RMT path is a working seed).
2026-08-21 fix(api): a real browser wedged httpd at seven sockets
    Safari holds up to six keep-alive connections per host; with the live
    socket that is exactly max_open_sockets, and every further fetch was
    refused — 'Load failed' on random requests (the author PUT, half the
    colour-lab pins) while single-connection clients never saw it.
    Thirteen sockets now (CONFIG_LWIP_MAX_SOCKETS 16), and LRU purging ON
    so a browser can never wedge the server again — with the push task
    marking each live client recent on every successful push, so the
    WebSocket monitor stops looking idle to the purge. That trade was the
    reason purging was off; the counter update dissolves it.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
2026-08-21 fix(web): attribute errors to the request that failed, and retry lost GETs once
    The author store showed 'Rejected' for a write the device had already
    committed — the merged catch blamed the PUT when the follow-up /info
    refresh was what Safari lost. Writes and refreshes now fail separately
    and say so, and idempotent GETs quietly retry once on network-level
    failures (never on an HTTP error: the device said no, and asking again
    would be pretending otherwise).
2026-08-21 fix(api): the CORS header was doubled on every ApplyResult endpoint
    Six handlers (ota x2, author x2, colortest x2) called add_cors at the
    top AND exited through send_protobuf/fail, which add it again —
    httpd_resp_set_hdr appends, and a doubled Allow-Origin is a CORS
    failure in every browser. So the device did the work and the browser
    reported 'Load failed': the author handle stored three times while
    the UI said Rejected, the colour lab changed LEDs while erroring, and
    node/pbtool saw nothing because they ignore CORS. Found in one run of
    WebKit under Playwright after the owner told me, correctly, to stop
    validating browser code without a browser.
    test/web/browser_check.js is that lesson ma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
2026-08-21 fix(api): the live-client table was raced from two tasks; fix(web): upload progress
    The push task and httpd's close_fn both mutated g_clients/-count with
    no lock; a double-remove underflowed the size_t count and the push
    loop walked four billion garbage entries — 1.3 million 'client 0
    dropped' lines and a dead board, triggered when an 80-second browser
    OTA upload kept httpd pinned while the browser's sockets churned.
    Every touch is now a critical section, removal is by-fd and
    idempotent (the race collapses to 'one of them wins'), and sends run
    against a snapshot so nothing blocks inside the lock.
    And the upload that exposed it gets a face: otaUpload moves to XHR
    for upload.onprogress —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
2026-08-21 feat(web): pause background polling during an OTA upload
    One radio, one httpd task: every concurrent request measurably slowed
    the upload (51 KB/s bare vs ~10 in-app). With the profiler poll held
    during the transfer, the full in-app flow measured 21 s in WebKit —
    progress bar, staged toast, armbox, discard — where it previously
    crawled past 100.
2026-08-22 feat(cloud): the S3 bundle, and the shell pointed at it
    The bundle lives at oneoffendeavors-pinled-webui (us-east-1), public
    GET with CORS for any origin — required, because the shell fetch()es
    index.html cross-origin from a http://<device> page. Bucket policy
    and CORS are checked in under tools/cloud/ as the record;
    tools/publish_webui.sh regenerates the schema text and syncs, assets
    before index so a mid-publish visitor never gets a torn pairing.
    index.html is no-cache, assets get an hour (unhashed, so an hour
    bounds staleness).
    And the bug the target state exposed before it shipped: the shell's
    <base href> makes RELATIVE urls resolve to the bundle — including
    fetch('/api/v1/...'), wh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
2026-08-22 feat(test): browser gate grows a shell mode; docs record the applied bundle
    'browser_check.js <device> both shell' drives the cloud path — device
    shell, S3 bundle, app booted, and an explicit assertion that API calls
    land on the device rather than the bundle, which is the <base> bug
    made permanently untestable-to-regress. All green in WebKit and
    Chromium against the live bucket.
2026-08-22 feat(web): the API reference — OpenAPI spec, vendored Swagger UI, Device-panel link
    web/api/openapi.yaml documents the shipped contract, written from
    api.h and the handlers' actual status codes — when it and the firmware
    disagree, the firmware is right and the yaml has a bug. Rendered by a
    vendored Swagger UI 5.17.14 (Apache-2.0, license alongside), docs-only
    because protobuf bodies make 'try it out' a lie. The spec ships as a
    generated classic script (tools/gen_openapi_js.py) so the page fetches
    nothing — file:// downloads render it identically to the S3 bundle.
    The Device panel's Identity card links to it relatively, so the docs
    travel with whichever copy of the app you opened; the b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
    [gen_openapi_js.py]
2026-08-22 fix(web): the docs back link returns to where you came from
    Under the shell, 'back to the app' resolved to the BUNDLE's index.html
    — an https origin that cannot call an http device (mixed content), so
    the app booted, asked S3 for /api/v1/info, and displayed S3's
    AccessDenied XML. The back link now uses the referrer's origin when it
    differs (the shell case) and stays relative for the file:// download,
    and an app booted on any https non-device origin now explains itself
    with directions instead of relaying S3's error.
    The gate clicks the link rather than navigating to it — only a real
    click carries the referrer the fix depends on — and asserts the back
    target in both modes: device origin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
2026-08-22 feat(web): the direct bundle visit gets a real explanation, and publishes bust caches
    Hitting the S3 index.html directly now lands on a proper page: why it
    cannot connect from here (https page, http device — browsers never
    allow the mix, by design the app is served BY the controller), where
    to go instead (pinled.local or the setup-page address), and what still
    works from the bundle (the API reference, the standalone-from-disk
    path).
    The reason the previous fix looked unshipped: assets cached an hour,
    so a fresh index ran a stale app.js. The publish script now stamps
    every local asset URL with ?v=<git-sha> in the UPLOADED index only —
    the no-cache index alone decides what browsers run, a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
2026-08-22 fix(review): docs entry points go no-cache; the shell gate cannot pass vacuously
    api/index.html and spec.js reference each other unstamped, so they
    join index.html in the no-cache tier — the same staleness class that
    served a user yesterday's app.js under today's index. And the shell
    gate's API-destination listener now attaches BEFORE navigation and
    requires at least one observation: boot's own calls are exactly the
    ones the <base> bug misdirected.
2026-08-22 feat(led): replace the zorxx driver with esp32-idf-ws2812b
    The in-house driver (reviewed and merged at b0eea3f) moves bytes;
    lamp_map decides them: colour order goes through bytes_for_order —
    the host-tested table — straight into write_raw, which transmits
    verbatim, MSB-first. wire8() is deleted, the version pin went with
    the dependency it pinned, and the tNeopixel word packing (whose
    'byte sent first lives in the middle' convention seeded years of
    confusion) is gone from the render path entirely. DMA on: the S3's
    one DMA-capable RMT channel was unclaimed, and the render task
    shares a machine with Wi-Fi.
    Acceptance on the bench: the Saleae capture (0x80 decodes as 0x80)
    and the green 25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
    [lamp_map.cpp, lamp_map.h]
2026-08-22 docs: the driver replacement, recorded where the bug was
2026-08-22 evidence: the new driver's wire capture — faithful, MSB-first, 30.00 us/pixel
    Saleae decode (GRB-configured decoder) of the colour-lab pin
    (46,255,0): wire bytes [0x2E, 0xFF, 0x00], byte-for-byte the logged
    pin. 0x2E is a non-palindrome — the old driver would have transmitted
    0x74 — so this single row closes the acceptance the replacement was
    specified around. Pixel spacing 30.00 us: datasheet-nominal.
    [newdriver.csv]
2026-08-22 docs: HW-9's shifter is a 74HCT14 at 5 V, two gates in series
    Owner's call 2026-08-22, reusing the Schmitt jellybean already in the
    design language — with the family trap spelled out: the front end's
    LVC14 cannot run at 5 V, plain HC at 5 V has the very threshold
    problem being solved, it must be HCT.
2026-08-22 docs: HW-9 refined — AHCT1G08 buffer on rev D, diode-fed HC14 on the bench
    Owner picked the SOT-23-5 single gate for board space; the prototype
    uses bin stock legitimately by dropping the HC14's rail to ~4.3 V so
    both of its interfaces meet spec instead of relocating the margin.
2026-08-22 docs: reference schematics for the three boards, as generated SVG
    Base (ESP32-S3 + first 16 channels), driver expansion module, and the
    per-socket lamp board — drawn with schemdraw from HARDWARE.md's own
    statements, iterated against rendered output until wires stopped
    crossing IC boxes. The generator is committed (tools/gen_schematics.py)
    so the sheets track the doc. Owner confirmed the board partition and
    the plain-'165 daisy chain (Q7→DS, shared CLK//PL) — closing a
    question this file had carried as inference since the bench era.
2026-08-22 docs: the clamp belongs on the FET output, and the record already said so
    The owner questioned the schematic's 3V3 clamp on the divider node,
    remembering a 9/12 V agreement. The record settles it three ways:
    every explicit statement (DOSSIER §246/§261, HARDWARE §281) clamps
    the FET OUTPUT to 3V3 — necessarily, since that node feeds a 74LVC14
    that is not 5 V-tolerant; the 9/12 V memory is the harness
    distribution trade study (TIMING §5) that lost to 5 V + local LDOs
    (HW-8); and the schematic had drawn the doc's clamp on the wrong
    node. The zener moves off the divider, a Schottky-to-3V3 appears on
    the drain where the checklist puts it, and HARDWARE.md's mermaid —
    whose compressed 'divi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
2026-08-22 docs: the front-end protection, per the owner's actual design
    Two corrections from the designer, restoring a decision the docs had
    lost and then half-invented:
    1. GATE side is the protection that matters: a 12 V zener, gate to
    source, per channel — the 2N7000's V_GS max is ±20 V against a
    ~24 V input span, and the divider cannot double as protection
    because its ~1/2 ratio is forced by needing real enhancement at
    6.3 V GI. (9.1 V pairs with a 1/3 ratio, rejected: GI/3 sits at
    the top of the Vth spread.) Both constraint inequalities recorded.
    2. OUTPUT side gets NO discrete clamp. The drain can only exceed the
    rail via C_gd-coupled charge from HV transients (and ESD) —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
